nicollsf/monsoon/report/pictures/shared image (17).jpeg

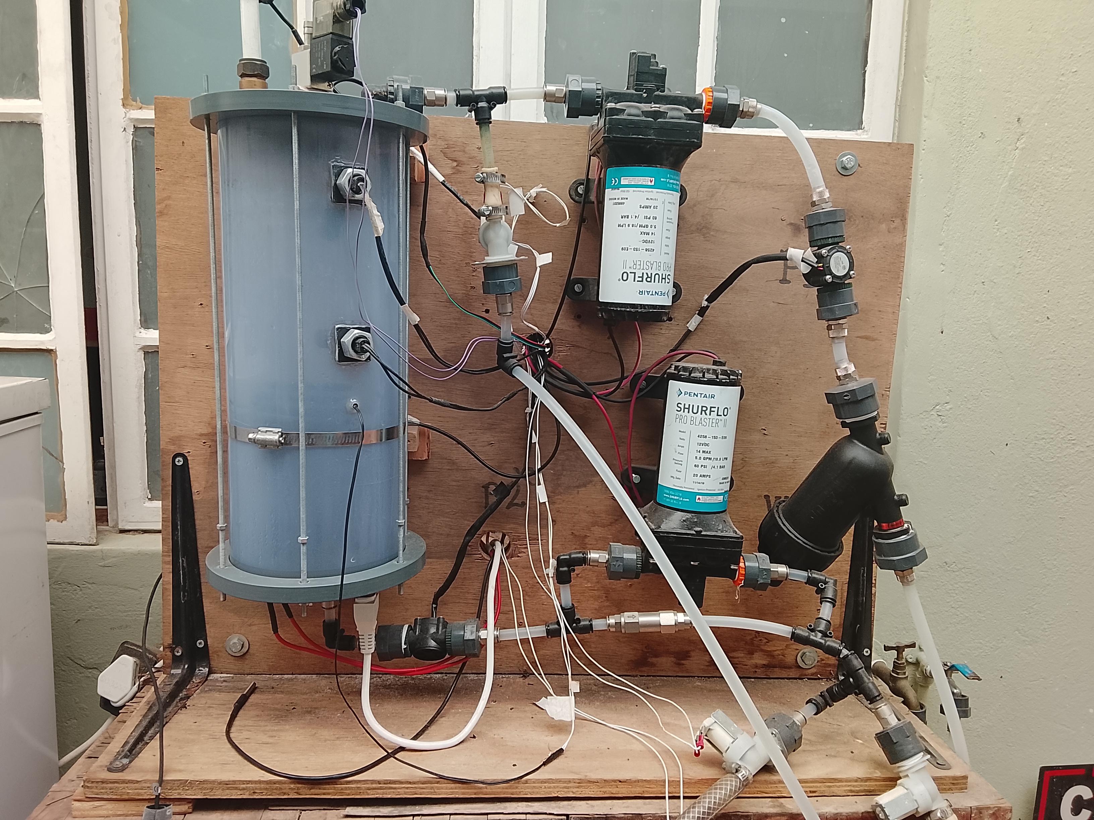
report/pictures/shared image (17).jpeg
