nicollsf/monsoon/report/monsoon.pptx

## Monsoon: The Journey

So many ways to go wrong

## Valves

## Slide 3

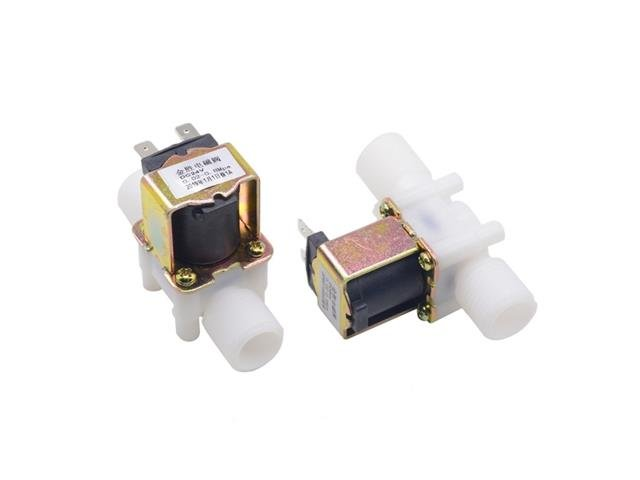
[picture p2: figure]

DC 12V

## Slide 4

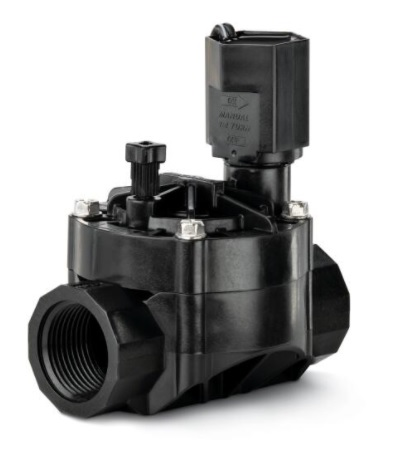
[picture p3: figure]

Irrigation

## Slide 5

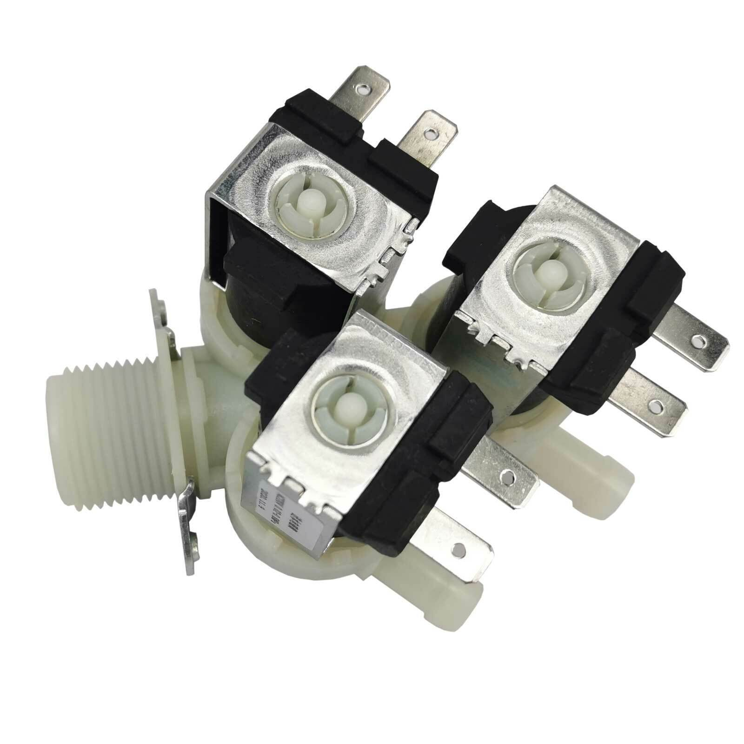
[picture p4: figure]

## Slide 6

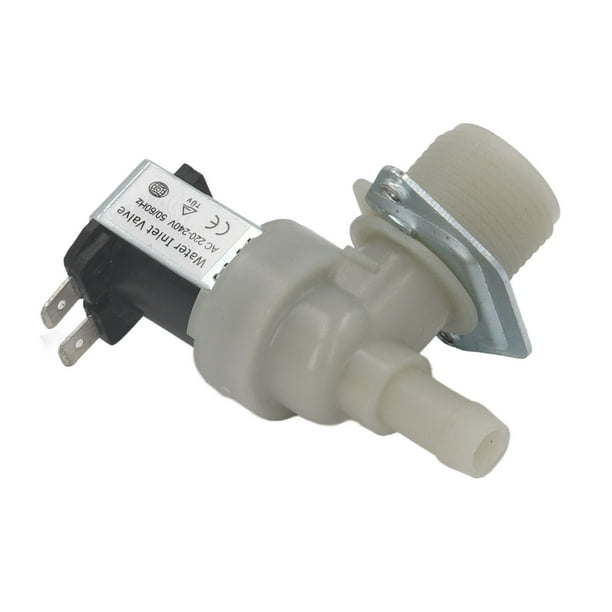
[picture p5: figure]

## Slide 7

- Don’t try to suck through a valve
- It’s a washing machine

## Pumps

## Slide 9

Agricultural

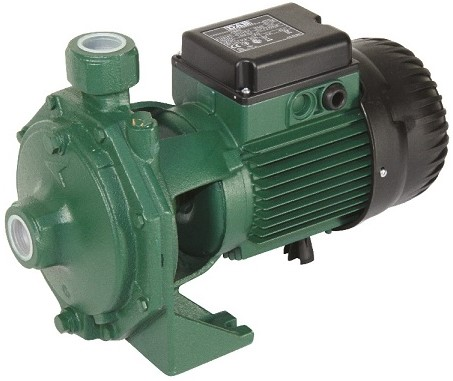
[picture p6: figure]

## Slide 10

Bilge

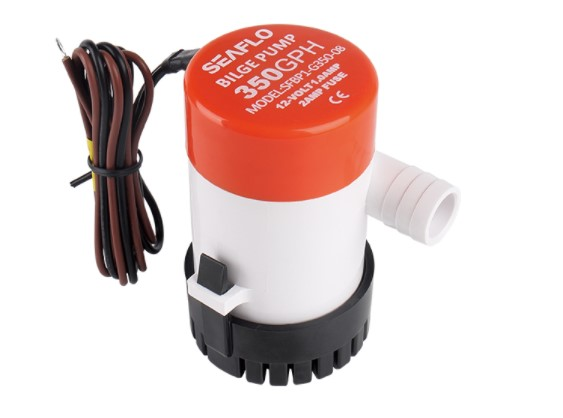
[picture p7: figure]

## Slide 11

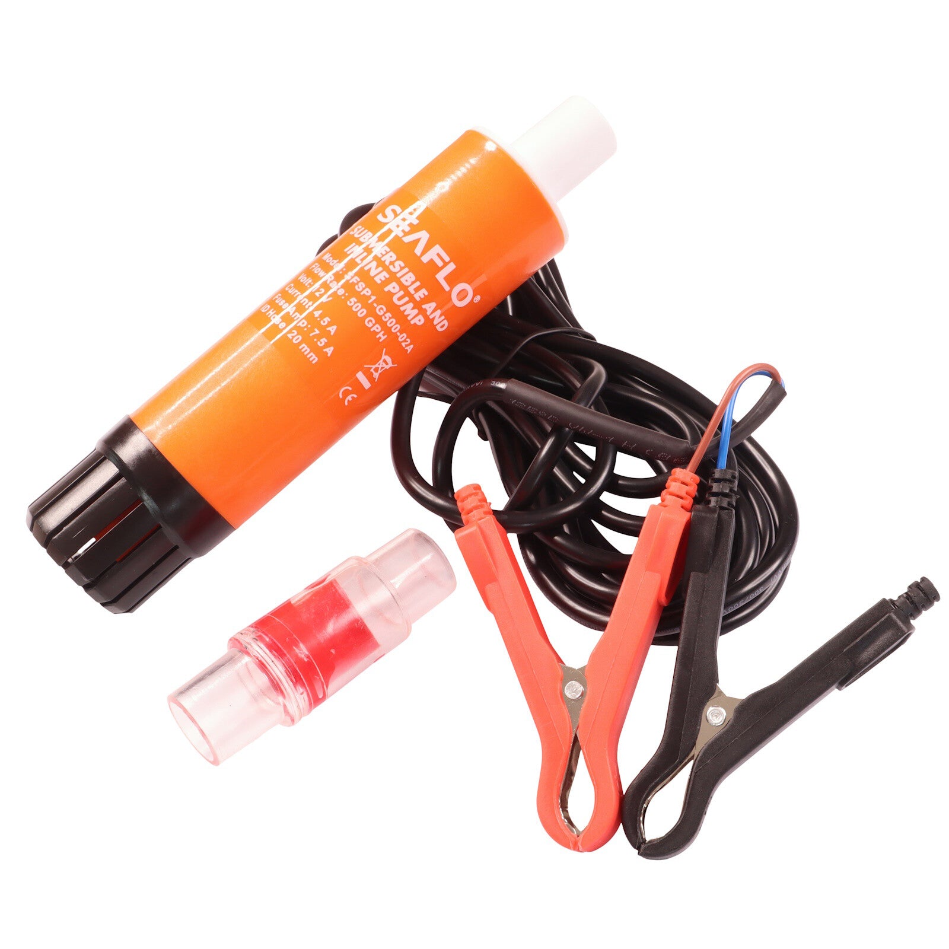
[picture p8: figure]

Centrifugal

## Slide 12

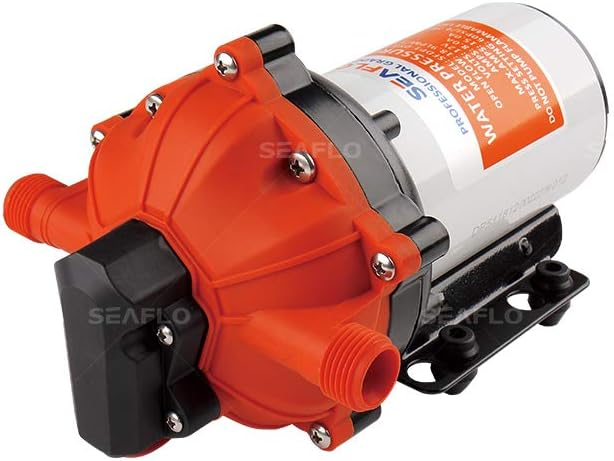
[picture p9: figure]

Washdown

## Prototype mark 2

## Slide 14

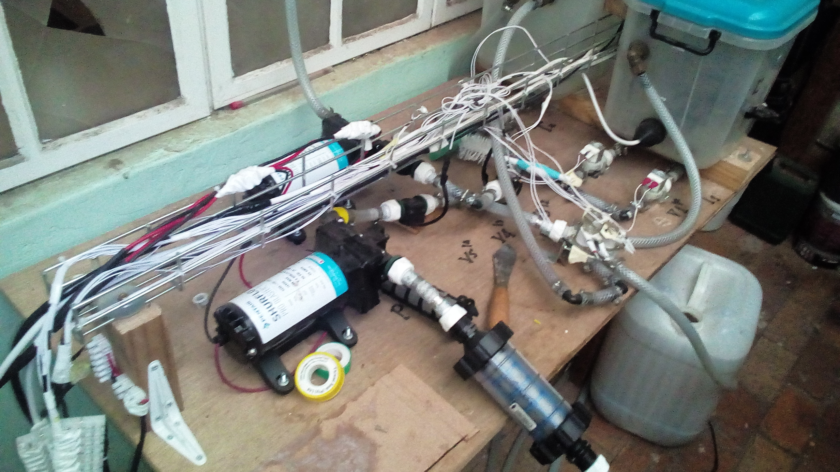
[picture p10: figure]

## Slide 15

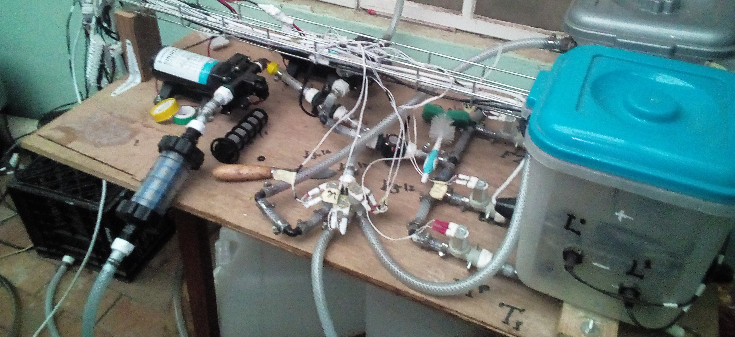
[picture p11: figure]

## Prototype Mark 3

## Slide 17

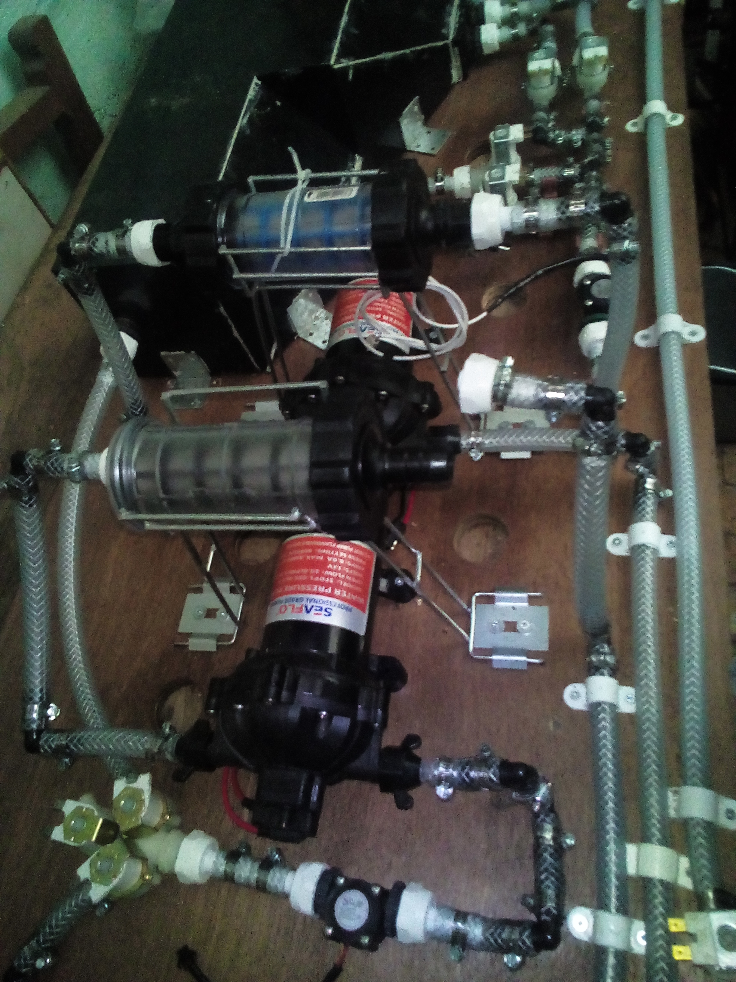
[picture p12: figure]
