nicollsf/monsoon/arduino/monsoon_mega3.1/heaterstep.pdf

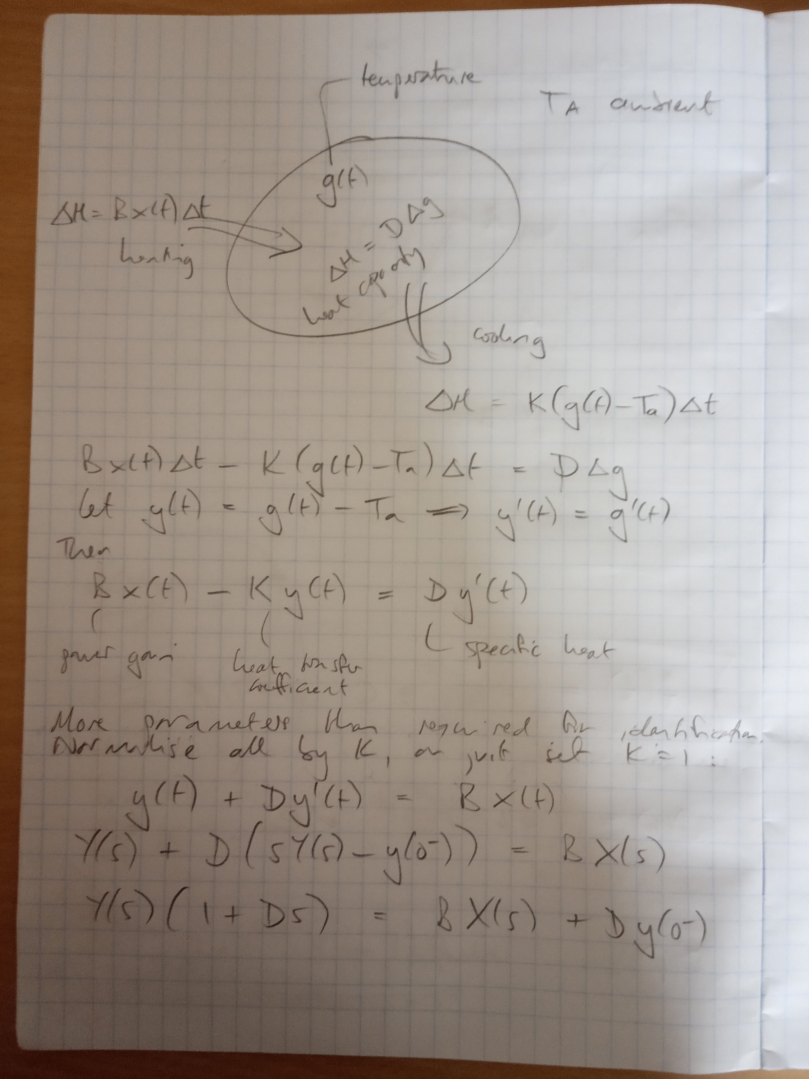
[picture p13: page 1]
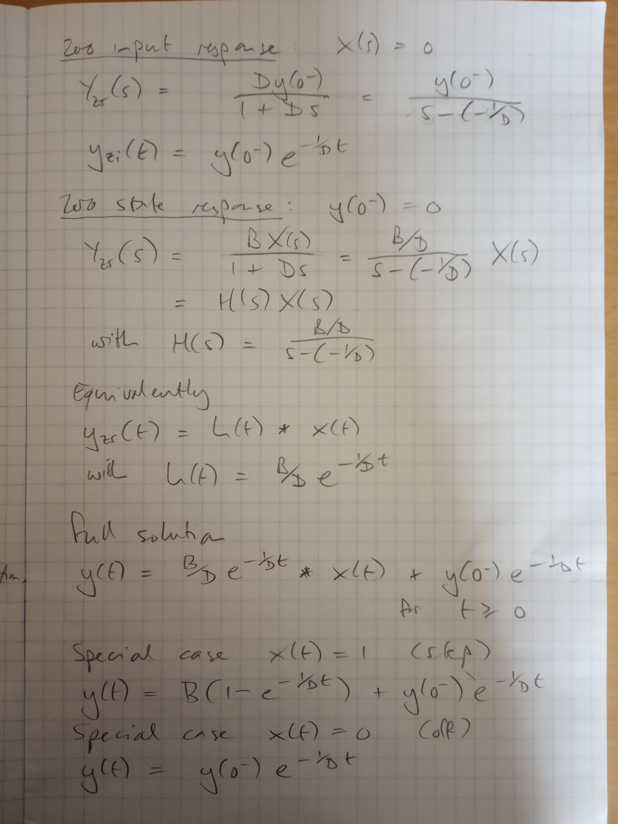
[picture p14: page 2]
