nicollsf/monsoon/arduino/monsoon_esp4.1/Wemos_D1_R32_pinout.png

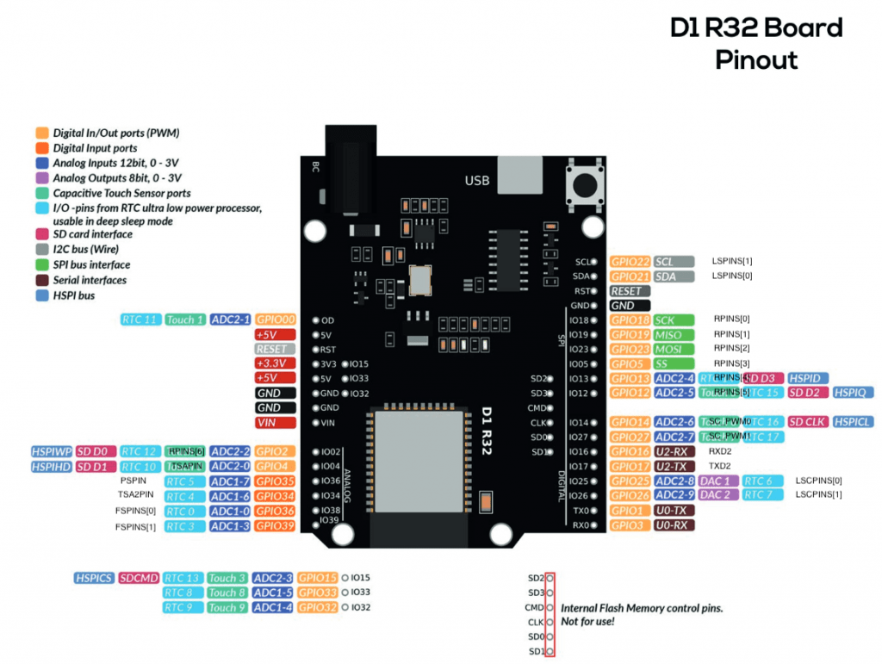
arduino/monsoon_esp4.1/Wemos_D1_R32_pinout.png
