nicollsf/monsoon/report/pictures/IMG_20180815_183408.jpg

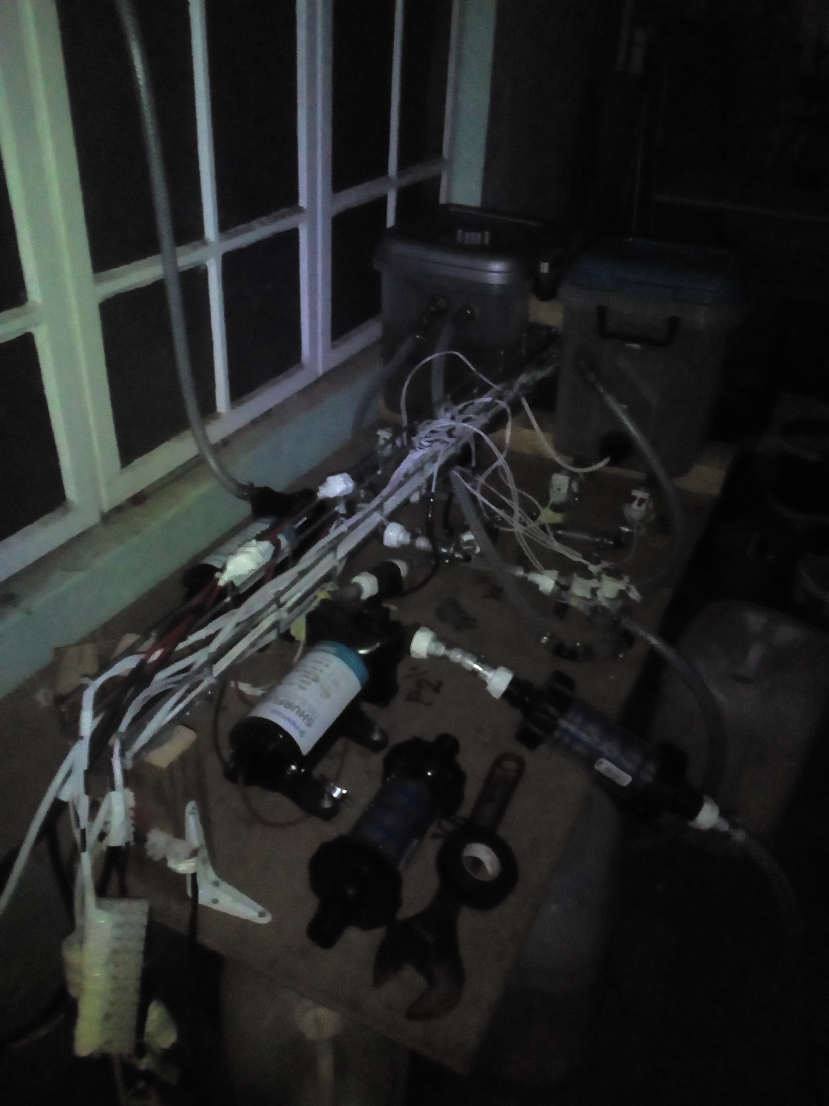
report/pictures/IMG_20180815_183408.jpg
