nicollsf/monsoon/report/pictures/IMG_20180815_183418.jpg

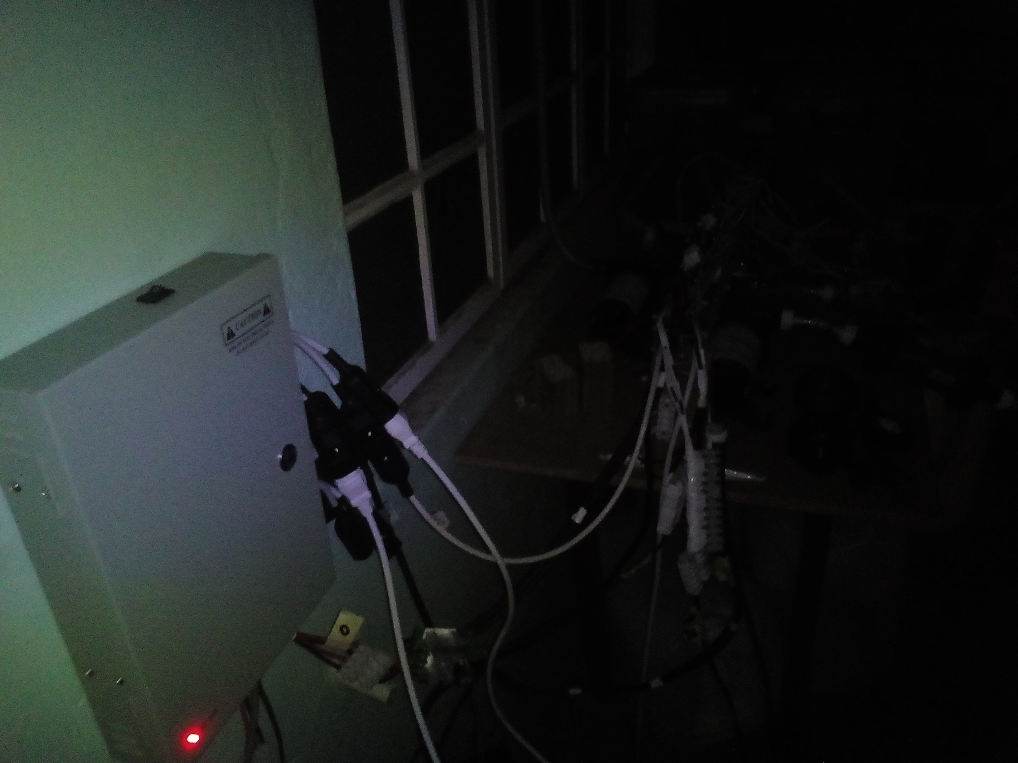
report/pictures/IMG_20180815_183418.jpg
