nicollsf/monsoon/report/pictures/IMG_20180919_072539.jpg

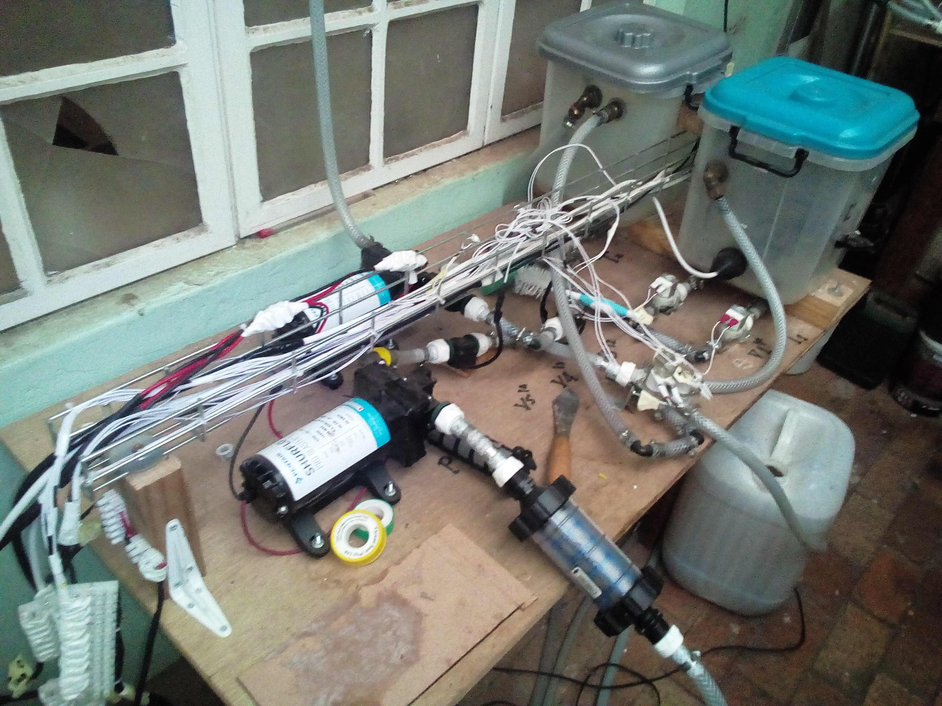
report/pictures/IMG_20180919_072539.jpg
