nicollsf/monsoon/report/pictures/IMG_20180919_072553.jpg

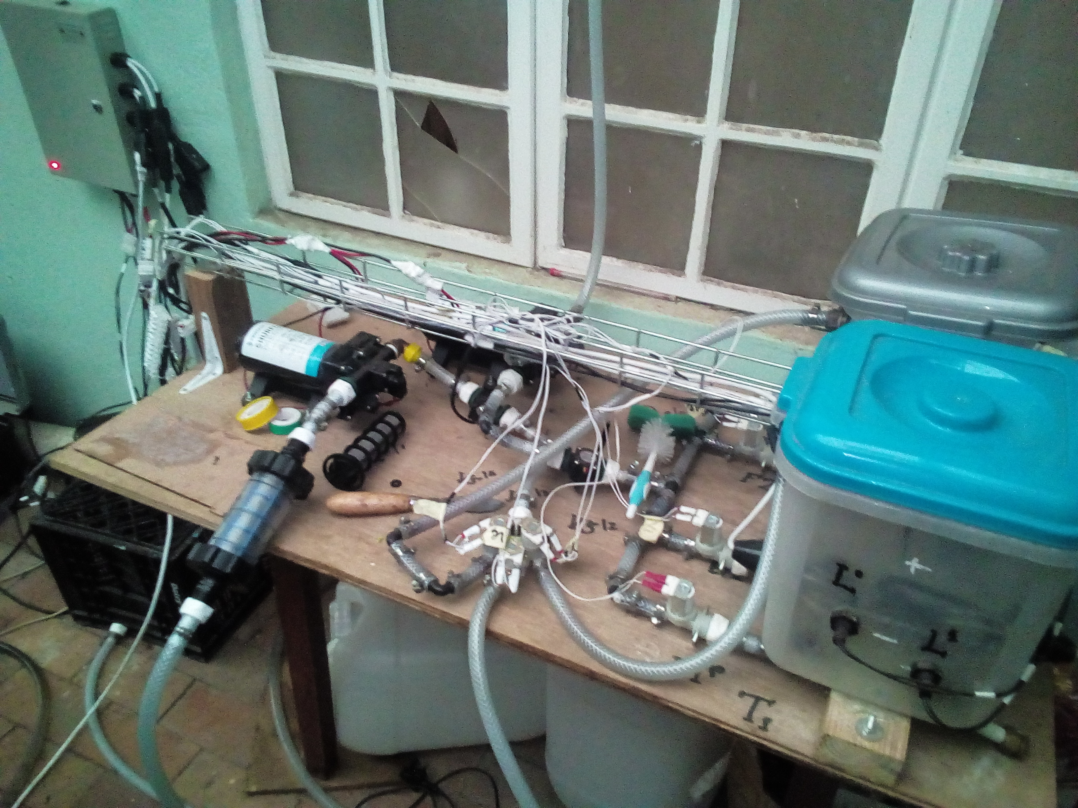
report/pictures/IMG_20180919_072553.jpg
