nicollsf/monsoon/report/pictures/shared image (13).jpeg

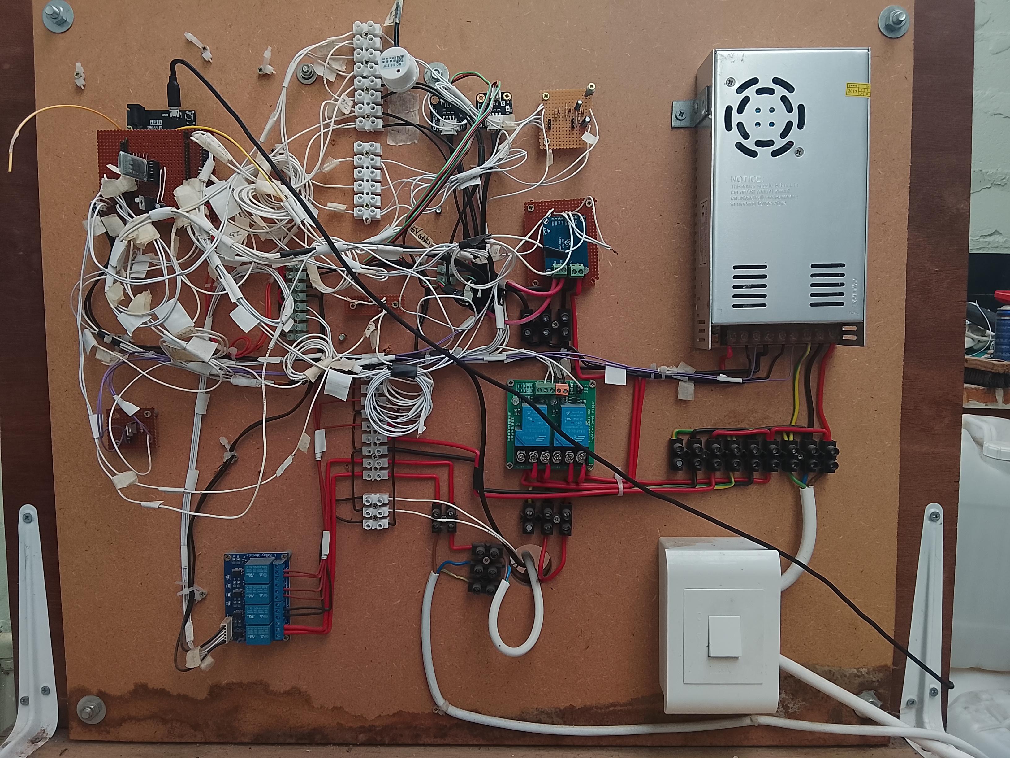
report/pictures/shared image (13).jpeg
