nicollsf/monsoon/report/pictures/shared image (14).jpeg

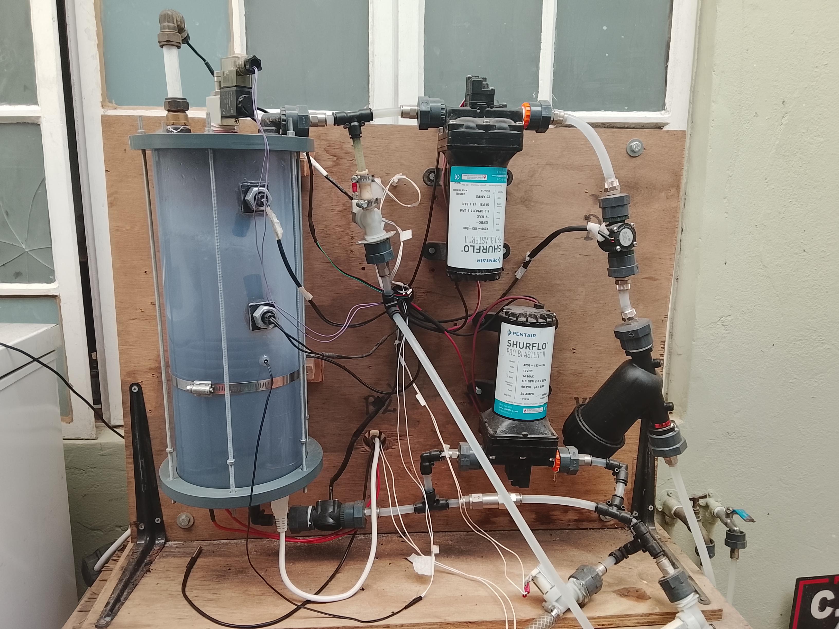
report/pictures/shared image (14).jpeg
