nicollsf/monsoon/tanks/Untitled.dxf

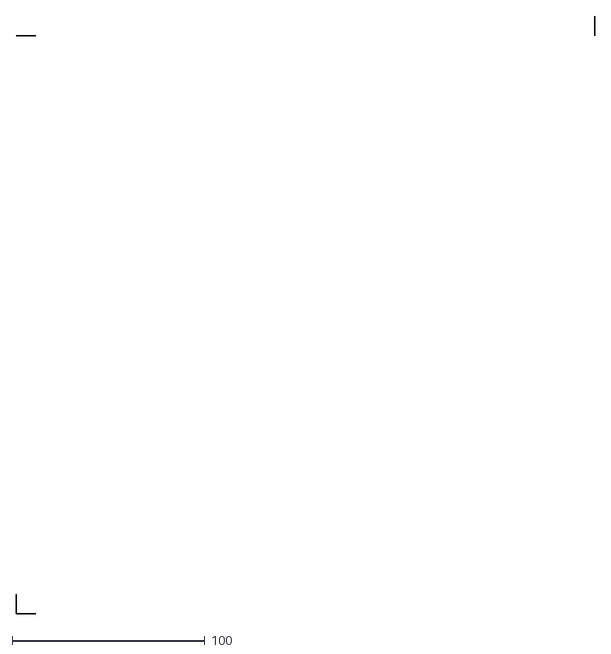
[picture p22: CAD file, 2026-03-22]
tanks/Untitled.dxf
300.0 x 310.0
