nicollsf/monsoon/tanks/tanks.dxf

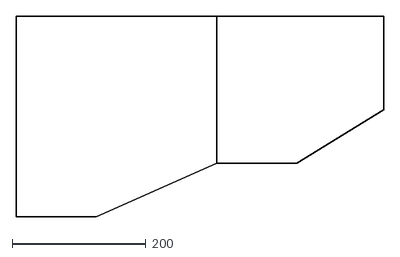
[picture p23: CAD file, 2026-03-22]
tanks/tanks.dxf
550.0 x 300.0
