nicollsf/monsoon/(list of files, drawings)

Other design files:
arduino/monsoon_esp4.1/heater_safety.fzz
arduino/monsoon_esp4.1/monsoon_esp.fzz
arduino/monsoon_esp4.2/monsoon_esp32devkit.fzz
arduino/monsoon_esp4/monsoon_esp.fzz
arduino/monsoon_mega2.1/monsoon_mega2.fzz
arduino/monsoon_mega2.2/monsoon_mega2.fzz
arduino/monsoon_mega2/monsoon_mega2.fzz
arduino/monsoon_mega3.1/monsoon_mega3.fzz
arduino/monsoon_mega3.2/monsoon_mega3.fzz
arduino/monsoon_mega3/monsoon_mega3.fzz
arduino/monsoon_mega/monsoon_mega.fzz
arduino/scavenge_level/scavenge_level.fzz
