nicollsf/monsoon/arduino/monsoon_esp4.2/calib.cpp

#include <Arduino.h>
#include <vector>
#include <Preferences.h>
#include "calib.h"
#include "auto.h"
#include "system.h"
#include "sensors.h"
#include "control.h"
#include "gui.h"

// ----------------------------------------------------------------------
//   Calibrations
// ----------------------------------------------------------------------

int calib_cind;
unsigned int calib_lastsettime;
unsigned int calib_laststagetime;


// Auto calibrate pumps

std::vector<float> calib_pumpperc = {10, 20, 30, 40, 50, 60, 70, 80, 90, 100};
std::vector<float> calib_dpumpmap, calib_rpumpmap;

const char *autocalibp_statestrs[] = {"NONE", "FILL", "PREPARE", "CALIB_DEL", "SCAV_PREP", "CALIB_SCAV", "DONE", "WTF"};
std::vector<float> pdpercv, trespv;
void loop_autocalibp(void)
{
  static int last_substate = -1;
  float flow_low, flow_high, current_target_lpm;

  if( auto_state!=STATE_CALIBP ) return;
  auto_substatestrs = autocalibp_statestrs;
  
  bool just_entered = (last_substate != auto_substate);
  last_substate = auto_substate;

  switch( auto_substate ) {
    case CALIBP_NONE:
      if( just_entered ) {
        auto_wtopupenable = 0;
        htrs_enable = 0;
        temp_controlmode = TCOFF;
        btLog("Entering CALIBP_NONE");
        calib_cind = -1;
        calib_dpumpmap.clear();
        calib_rpumpmap.clear();
      }
      Serial.println("Switching substate to CALIBP_FILL");
      auto_switchsubstate(CALIBP_FILL);
      break;

    case CALIBP_FILL:
      if( just_entered ) {
        btLog("CALIBP: Filling tank from mains inlet.");
        setrelay_en(RPINLET, RON);
      }

      if( tank_full ) {
        btLog("CALIBP: Tank is full. Moving to prepare/prime stage.");
        setrelay_en(RPINLET, ROFF);
        auto_switchsubstate(CALIBP_PREPARE);
      }
      break;

    case CALIBP_PREPARE:
      if( just_entered ) {
        btLog("CALIBP: Priming/stabilising circuit. SCAVENGE 100%, DELIVERY 50%, top-up ON.");
        setrelay_en(RPDELIVER, RON);
        setpump_en(RPUMPR, RON);
        setpump_en(RPUMPD, RON);
        setpump_perc(RPUMPR, 100);
        setpump_perc(RPUMPD, 50); // delivery ~50%
        auto_wtopupenable = 1;
      }

      // Wait for tank to be full and flow to be stable for 20s
      if( tank_full && (millis() - flow_lastlt1 > 20000) ) {
        btLog("CALIBP: Flow stable. Starting delivery pump calibration.");
        calib_cind = -1;
        auto_switchsubstate(CALIBP_CALIB_DELIVERY);
      }
      break;

    case CALIBP_CALIB_DELIVERY:
      if( just_entered ) {
        btLog("CALIBP: Starting delivery pump calibration step series.");
        calib_dpumpmap.clear();
        calib_cind = 0;
        setrelay_en(RPDELIVER, RON);
        setpump_en(RPUMPR, RON);
        setpump_perc(RPUMPR, 100); // Scavenge full to clear pan
        setpump_en(RPUMPD, RON);
        setpump_perc(RPUMPD, calib_pumpperc[calib_cind]);
        auto_wtopupenable = 1; // Keep tank full during delivery calibration
        calib_lastsettime = millis();
      }

      // Safeguard check
      if( tank_empty ) {
        btLog("ERROR: Tank level low during Delivery Calib. Aborting.");
        pumpsen_reset();
        auto_switchstate(STATE_OFF);
        return;
      }

      if( millis() - calib_lastsettime >= 5000 ) {
        float measured_flow = flow_lpm0;
        calib_dpumpmap.push_back(measured_flow);
        btLog("CALIBP: Delivery " + String(calib_pumpperc[calib_cind], 0) + "% -> Flow: " + String(measured_flow, 2) + " LPM");

        if( calib_cind < (int)calib_pumpperc.size() - 1 ) {
          calib_cind++;
          setpump_perc(RPUMPD, calib_pumpperc[calib_cind]);
          calib_lastsettime = millis();
        } else {
          // Delivery calibration complete
          std::vector<float> dpump_pwms;
          std::vector<float> dpump_flows;
          for (size_t i = 0; i < calib_pumpperc.size(); i++) {
            if (calib_pumpperc[i] <= 90.0f) {
              dpump_pwms.push_back(calib_pumpperc[i]);
              dpump_flows.push_back(calib_dpumpmap[i]);
            }
          }
          modeld = pumpcalib_fit(dpump_pwms, dpump_flows);
          pumpcalib_savemodels();
          btLog("CALIBP: Delivery pump calibration finished. Model fitted and saved.");
          auto_switchsubstate(CALIBP_SCAVENGE_PREP);
        }
      }
      break;

    case CALIBP_SCAVENGE_PREP:
      if( just_entered ) {
        btLog("CALIBP: Flooding pan. Scavenge off, top-up off, Delivery 90% until level low.");
        setpump_en(RPUMPR, ROFF);
        auto_wtopupenable = 0;
        setrelay_en(RPINLET, ROFF);
        setrelay_en(RPDELIVER, RON);
        setpump_perc(RPUMPD, 90);
        setpump_en(RPUMPD, RON);
      }

      // Wait until bottom level sensor hits low (which means pan is flooded/full)
      if( tank_empty ) {
        btLog("CALIBP: Tank level hit low (pan is full). Starting scavenge calibration steps.");
        calib_cind = -1;
        auto_switchsubstate(CALIBP_CALIB_SCAVENGE);
      }
      break;

    case CALIBP_CALIB_SCAVENGE:
      if( just_entered ) {
        btLog("CALIBP: Starting scavenge pump calibration step series with dynamic delivery.");
        calib_rpumpmap.clear();
        calib_cind = 0;
        setrelay_en(RPDELIVER, RON);
        setpump_perc(RPUMPR, calib_pumpperc[calib_cind]);
        setpump_en(RPUMPR, RON);
        calib_lastsettime = millis();
      }

      // Dynamic Delivery pump control:
      // drive the DELIVERY pump full (90%) when the tank level is high and have it off when the level is low.
      if( tank_full ) {
        setpump_perc(RPUMPD, 90);
        setpump_en(RPUMPD, RON);
      } else {
        setpump_en(RPUMPD, ROFF);
      }

      if( millis() - calib_lastsettime >= 5000 ) {
        float measured_flow = flow_lpm1;
        calib_rpumpmap.push_back(measured_flow);
        btLog("CALIBP: Scavenge " + String(calib_pumpperc[calib_cind], 0) + "% -> Flow: " + String(measured_flow, 2) + " LPM");

        if( calib_cind < (int)calib_pumpperc.size() - 1 ) {
          calib_cind++;
          setpump_perc(RPUMPR, calib_pumpperc[calib_cind]);
          calib_lastsettime = millis();
        } else {
          // Scavenge calibration finished
          modelr = pumpcalib_fit(calib_pumpperc, calib_rpumpmap);
          pumpcalib_savemodels();
          btLog("CALIBP: Scavenge pump calibration finished. Model fitted and saved.");
          auto_switchsubstate(CALIBP_DONE);
        }
      }
      break;

    case CALIBP_DONE:
      if( just_entered ) {
        auto_woverflowstopenable = 0;
        pumpsen_reset();
      }
      auto_switchstate(STATE_CALIBT);
      break;
  }
}


// Auto calibrate temperature (5 LPM step response & thermal lag characterization)
enum autocalibt_states {
  CALIBT_NONE = 0,
  CALIBT_BASELINE_IDLE,  // 1-2 min at 5 LPM with 0 kW heaters to reach flat baseline T0
  CALIBT_STEP_HEAT,      // Full 6 kW step test at 5 LPM until water reaches 50.0 C
  CALIBT_STABILIZE_HOLD, // Step down to ~4.8 kW (estimated 5 LPM hold) to observe steady-state
  CALIBT_COOL_DECAY,     // 0 kW heaters at 5 LPM to measure thermal decay / lag
  CALIBT_DONE
};

struct TempLogPoint {
  uint16_t time_sec;
  float temp_c;
  float flow0;
  float flow1;
  uint8_t target_lpm_x10;
  uint8_t power_kw_x10;
} __attribute__((packed));
std::vector<TempLogPoint> temp_response_log;

const char *autocalibt_statestrs[] = {"NONE", "BASELINE", "STEP_HEAT", "STABILIZE", "COOL_DECAY", "DONE", "WTF"};
void loop_autocalibt(void)
{
  static int last_substate = -1;
  static unsigned long last_sample_time = 0;
  static unsigned long substate_start_time = 0;
  static float baseline_temp = 0.0f;

  const float CALIB_FLOW_LPM = 5.0f;       // Fixed delivery flow rate for test
  const float TARGET_HEAT_TEMP = 50.0f;     // Target heating ceiling
  const float MAX_SAFETY_TEMP = 55.0f;      // Abort threshold

  if( auto_state!=STATE_CALIBT ) return;
  auto_substatestrs = autocalibt_statestrs;

  bool just_entered = (last_substate != auto_substate);
  last_substate = auto_substate;

  if (just_entered) {
    substate_start_time = millis();
  }

  // Periodic 1-second data logging into temp_response_log
  if (millis() - last_sample_time >= 1000) {
    last_sample_time = millis();
    bool aux_on = (getrelay_en(RPHEATERA) == RON);
    float current_kw = (4.0f * ssr_main_duty) + (aux_on ? 2.0f : 0.0f);

    TempLogPoint p;
    p.time_sec = (uint16_t)((millis() - auto_statestime) / 1000);
    p.temp_c = temp1;
    p.flow0 = flow_lpm0;
    p.flow1 = flow_lpm1_est;
    p.target_lpm_x10 = (uint8_t)(CALIB_FLOW_LPM * 10);
    p.power_kw_x10 = (uint8_t)(current_kw * 10.0f + 0.5f);
    temp_response_log.push_back(p);
  }
  
  switch( auto_substate ) {
    case CALIBT_NONE:
      if( just_entered ) {
        btLog("CALIBT: Initializing 5.0 LPM Thermal Lag & Step Test.");
        auto_wtopupenable = 0;
        auto_woverflowstopenable = 1;
        auto_scavengecontrolenable = 1; // Closed-loop recovery matching WASH
        temp_controlmode = TCNONE;      // Direct manual control of heaters in this state
        htrs_enable = 1;
        ssr_main_duty = 0.0f;
        setrelay_en(RPHEATER, ROFF);
        setrelay_en(RPHEATERA, ROFF);

        temp_response_log.clear();
        temp_response_log.reserve(1200);

        Preferences p;
        p.begin("calibt", false);
        p.clear();
        p.end();
      }
      auto_switchsubstate(CALIBT_BASELINE_IDLE);
      break;

    case CALIBT_BASELINE_IDLE: {
      // Phase 1: Unheated baseline at 5.0 LPM with closed-loop scavenge
      if( just_entered ) {
        btLog("CALIBT Phase 1: Baseline idle (0 kW @ 5.0 LPM) for 90s to reach thermal equilibrium.");
        setrelay_en(RPDELIVER, RON);
        setpump_en(RPUMPD, RON);
        setpump_en(RPUMPR, RON);
        auto_scavengecontrolenable = 1;
        setpump_lpm(RPUMPD, CALIB_FLOW_LPM);

        ssr_main_duty = 0.0f;
        setrelay_en(RPHEATER, ROFF);
        setrelay_en(RPHEATERA, ROFF);
      }

      unsigned long elapsed = millis() - substate_start_time;
      // Wait 90 seconds (1.5 min) to reach flat initial baseline
      if (elapsed >= 90000) {
        baseline_temp = temp1;
        btLog("CALIBT: Baseline established at " + String(baseline_temp, 2) + " C. Commencing 6.0 kW Step!");
        auto_switchsubstate(CALIBT_STEP_HEAT);
      }
      break;
    }

    case CALIBT_STEP_HEAT: {
      // Phase 2: Instantaneous 6 kW step test at 5.0 LPM until 50.0 C
      if( just_entered ) {
        btLog("CALIBT Phase 2: 6.0 kW STEP (Main 100% + Aux ON) @ 5.0 LPM. Heating towards " + String(TARGET_HEAT_TEMP, 1) + " C.");
        setrelay_en(RPDELIVER, RON);
        setpump_en(RPUMPD, RON);
        setpump_en(RPUMPR, RON);
        auto_scavengecontrolenable = 1;
        setpump_lpm(RPUMPD, CALIB_FLOW_LPM);

        ssr_main_duty = 1.0f;
        setrelay_en(RPHEATER, RON);
        setrelay_en(RPHEATERA, RON); // Full 6 kW
      }

      // Check if target temperature reached or safety limit
      if (temp1 >= TARGET_HEAT_TEMP) {
        btLog("CALIBT: Target 50 C reached (T=" + String(temp1, 2) + " C). Transitioning to stabilization hold.");
        auto_switchsubstate(CALIBT_STABILIZE_HOLD);
      } else if (temp1 >= MAX_SAFETY_TEMP) {
        btLog("WARNING: Max safety temp reached. Aborting to decay.");
        auto_switchsubstate(CALIBT_COOL_DECAY);
      }
      break;
    }

    case CALIBT_STABILIZE_HOLD: {
      // Phase 3: Hold power to stabilize around 50 C
      // At 5 LPM and dT ~ (50 - 25) = 25 C: equilibrium power is ~4.8 kW (Aux 2kW + Main 70% = 4.8 kW)
      if( just_entered ) {
        btLog("CALIBT Phase 3: Stabilizing at ~4.8 kW (Aux ON + Main 70%) @ 5.0 LPM.");
        setrelay_en(RPDELIVER, RON);
        setpump_en(RPUMPD, RON);
        setpump_en(RPUMPR, RON);
        auto_scavengecontrolenable = 1;
        setpump_lpm(RPUMPD, CALIB_FLOW_LPM);

        setrelay_en(RPHEATERA, RON); // 2 kW
        ssr_main_duty = 0.70f;        // 2.8 kW (4.8 kW total)
        setrelay_en(RPHEATER, RON);
      }

      unsigned long hold_elapsed = millis() - substate_start_time;

      // Check for stability: after at least 60s, check if temp drift over last 30s is < 0.15 C
      if (hold_elapsed >= 60000 && temp_response_log.size() >= 30) {
        float temp_30s_ago = temp_response_log[temp_response_log.size() - 30].temp_c;
        if (abs(temp1 - temp_30s_ago) <= 0.15f || hold_elapsed >= 180000) { // 3 min max hold
          btLog("CALIBT: Temperature stabilized at " + String(temp1, 2) + " C (Hold power 4.8 kW). Commencing unheated decay.");
          auto_switchsubstate(CALIBT_COOL_DECAY);
        }
      }
      break;
    }

    case CALIBT_COOL_DECAY: {
      // Phase 4: Zero-power thermal decay at 5.0 LPM
      // Target: Decay until 5 degrees above ambient (or 10 minutes max, whichever first)
      float amb_ref = (baseline_temp > 10.0f) ? baseline_temp : ambient_water_cold;
      float decay_target_temp = amb_ref + 5.0f;
      const unsigned long MAX_DECAY_DURATION = 600000; // 10 minutes (600,000 ms)

      if( just_entered ) {
        btLog("CALIBT Phase 4: Heaters 0% (0 kW). Logging temperature decay at 5.0 LPM towards " + 
              String(decay_target_temp, 1) + " C (Amb+5C or 10 min max).");
        setrelay_en(RPDELIVER, RON);
        setpump_en(RPUMPD, RON);
        setpump_en(RPUMPR, RON);
        auto_scavengecontrolenable = 1;
        setpump_lpm(RPUMPD, CALIB_FLOW_LPM);

        ssr_main_duty = 0.0f;
        setrelay_en(RPHEATER, ROFF);
        setrelay_en(RPHEATERA, ROFF);
      }

      unsigned long decay_elapsed = millis() - substate_start_time;
      bool target_reached = (temp1 <= decay_target_temp);
      bool timeout = (decay_elapsed >= MAX_DECAY_DURATION);

      // Log cooling decay until within 5C of ambient or 10 minutes
      if (target_reached || timeout) {
        if (target_reached) {
          btLog("CALIBT Phase 4 complete: Temperature reached " + String(temp1, 2) + " C (Amb+5C reached in " + 
                String(decay_elapsed / 1000) + "s).");
        } else {
          btLog("CALIBT Phase 4 complete: 10-minute timeout reached. Final temp: " + String(temp1, 2) + " C.");
        }
        calib_archive_log();
        auto_switchsubstate(CALIBT_DONE);
      }
      break;
    }

    case CALIBT_DONE:
      if( just_entered ) {
        btLog("CALIBT: Test complete. Switching to CALIBDUMP.");
        auto_woverflowstopenable = 0;
        auto_scavengecontrolenable = 0;
        temp_controlmode = TCNONE;
        ssr_main_duty = 0.0f;
        setrelay_en(RPHEATER, ROFF);
        setrelay_en(RPHEATERA, ROFF);
        pumpsen_reset();
      }
      auto_switchstate(STATE_CALIBDUMP);
      break;
  }
}


// Auto calibrate dump
enum autocalibdump_states {
  CALIBDUMP_NONE = 0,
  CALIBDUMP_DUMP,
  CALIBDUMP_DONE
};
const char *autocalibdump_statestrs[] = {"NONE", "DUMP", "DONE", "WTF"};
void loop_autocalibdump(void)
{
  static int last_substate = -1;
  if( auto_state!=STATE_CALIBDUMP ) return;
  auto_substatestrs = autocalibdump_statestrs;
  
  bool just_entered = (last_substate != auto_substate);
  last_substate = auto_substate;

  switch( auto_substate ) {
    case CALIBDUMP_NONE:
      if( just_entered ) btLog("Entering CALIBDUMP_NONE");
      auto_switchsubstate(CALIBDUMP_DUMP);
      break;

    case CALIBDUMP_DUMP:
      if( just_entered ) {
        btLog("Dumping Calibration Info from NVRAM");
        
        Serial.println("\n--- START STORED PUMP MODELS ---");
        Serial.printf("Model R: offset=%.2f, a=%.4f, b=%.4f, maxflow=%.2f\n", modelr.offset, modelr.a, modelr.b, modelr.maxflow);
        Serial.printf("Model D: offset=%.2f, a=%.4f, b=%.4f, maxflow=%.2f\n", modeld.offset, modeld.a, modeld.b, modeld.maxflow);
        Serial.println("--- END STORED PUMP MODELS ---\n");

        extern void mqtt_log(String slog);
        mqtt_log("CALIB_PUMP_MODEL_R: offset=" + String(modelr.offset) + ", a=" + String(modelr.a, 4) + ", b=" + String(modelr.b, 4) + ", maxflow=" + String(modelr.maxflow));
        mqtt_log("CALIB_PUMP_MODEL_D: offset=" + String(modeld.offset) + ", a=" + String(modeld.a, 4) + ", b=" + String(modeld.b, 4) + ", maxflow=" + String(modeld.maxflow));

        {
          Preferences p;
          p.begin("calibt", false);
          size_t len = 0;
          if (p.isKey("log")) {
             len = p.getBytesLength("log");
          }
          if (len > 0 && (len % sizeof(TempLogPoint) == 0)) {
             uint8_t* buf = new uint8_t[len];
             p.getBytes("log", buf, len);
             int count = len / sizeof(TempLogPoint);
             TempLogPoint* pts = (TempLogPoint*)buf;
             Serial.println("Time_sec, Target_LPM, Power_kW, Temp_C, Flow_LPM0, Flow_LPM1");
             
             mqtt_log("CALIB_TEMP_LOG_START");
             for(int i=0; i<count; i++) {
               float p_kw = pts[i].power_kw_x10 / 10.0f;
               Serial.printf("%d, %.1f, %.1f, %.2f, %.2f, %.2f\n", pts[i].time_sec, pts[i].target_lpm_x10/10.0f, p_kw, pts[i].temp_c, pts[i].flow0, pts[i].flow1);
               String pts_str = "CALIB_PT: t=" + String(pts[i].time_sec) + 
                                ", target=" + String(pts[i].target_lpm_x10/10.0f, 1) + 
                                ", kw=" + String(p_kw, 1) + 
                                ", temp=" + String(pts[i].temp_c, 2) + 
                                ", flow0=" + String(pts[i].flow0, 2) + 
                                ", flow1=" + String(pts[i].flow1, 2);
               mqtt_log(pts_str);
             }
             mqtt_log("CALIB_TEMP_LOG_END");
             
             delete[] buf;
          } else {
             Serial.println("No NVRAM temp log found.");
             mqtt_log("CALIB_TEMP_LOG_EMPTY");
          }
          p.end();
        }

        Serial.println("========================================\n");
      }

      auto_switchsubstate(CALIBDUMP_DONE);
      break;

    case CALIBDUMP_DONE:
      if( just_entered ) auto_switchstate(STATE_OFF);
      break;
  }
}

// Auto calibrate relative flow between turbine meters (Switch-to-Switch Volumetric Ratio)
const char *autocalibf_statestrs[] = {"NONE", "INIT_FILL", "DRAIN_DEL", "FILL_REC", "CALC", "DONE", "WTF"};

static int calibf_cycle = 0;
const int CALIBF_MAX_CYCLES = 6;
const float calibf_pwms[CALIBF_MAX_CYCLES] = {30.0f, 40.0f, 52.0f, 65.0f, 80.0f, 95.0f};

static unsigned long calibf_del_pulses[CALIBF_MAX_CYCLES];
static unsigned long calibf_rec_pulses[CALIBF_MAX_CYCLES];
static unsigned long calibf_del_dur_ms[CALIBF_MAX_CYCLES];
static unsigned long calibf_rec_dur_ms[CALIBF_MAX_CYCLES];

void loop_autocalibf(void)
{
  static int last_substate = -1;
  extern void mqtt_log(String slog);

  if( auto_state != STATE_CALIBF ) return;
  auto_substatestrs = autocalibf_statestrs;

  bool just_entered = (last_substate != auto_substate);
  last_substate = auto_substate;

  switch( auto_substate ) {
    case CALIBF_NONE:
      if( just_entered ) {
        auto_wtopupenable = 0;
        auto_woverflowstopenable = 0;
        auto_scavengecontrolenable = 0;
        htrs_enable = 0;
        temp_controlmode = TCOFF;
        calibf_cycle = -1; // Start with unrecorded warmup/purge cycle
        for (int i = 0; i < CALIBF_MAX_CYCLES; i++) {
          calibf_del_pulses[i] = 0;
          calibf_rec_pulses[i] = 0;
          calibf_del_dur_ms[i] = 0;
          calibf_rec_dur_ms[i] = 0;
        }
        btLog("CALIBF: Starting Multi-Point Flow Calibration (Warmup + 6 speeds).");
        mqtt_log("CALIBF: Starting Multi-Point Flow Calibration (Warmup + 6 speeds: 30%, 40%, 52%, 65%, 80%, 95% PWM).");
      }
      if (tank_full) {
        auto_switchsubstate(CALIBF_DRAIN_DELIVERY);
      } else {
        auto_switchsubstate(CALIBF_INIT_FILL);
      }
      break;

    case CALIBF_INIT_FILL:
      if( just_entered ) {
        btLog("CALIBF: Charging tank with mains inlet to Top Float switch...");
        mqtt_log("CALIBF: Charging tank to Top Float...");
        setrelay_en(RPINLET, RON);
      }
      if (tank_full) {
        setrelay_en(RPINLET, ROFF);
        btLog("CALIBF: Tank full reached. Starting Warmup Drain Phase.");
        auto_switchsubstate(CALIBF_DRAIN_DELIVERY);
      }
      break;

    case CALIBF_DRAIN_DELIVERY: {
      float current_pwm = (calibf_cycle < 0) ? 50.0f : calibf_pwms[calibf_cycle];
      if( just_entered ) {
        flow_reset_total_pulses();
        calib_lastsettime = millis();
        setrelay_en(RPINLET, ROFF);
        setrelay_en(RPDRAIN, ROFF);
        setrelay_en(RPDELIVER, RON);
        setrelay_en(RPPUMP, RON);
        setpump_en(RPUMPR, ROFF);
        setpump_perc(RPUMPR, 0);
        setpump_perc(RPUMPD, current_pwm);
        setpump_en(RPUMPD, RON);

        String msg;
        if (calibf_cycle < 0) {
          msg = "CALIBF [WARMUP] DRAIN: Running Delivery at 50% PWM to purge air & prime lines...";
        } else {
          msg = "CALIBF [Cycle " + String(calibf_cycle + 1) + "/" + String(CALIBF_MAX_CYCLES) + 
                "] DRAIN: Running Delivery at " + String(current_pwm, 0) + "% PWM until Bottom Float...";
        }
        btLog(msg);
        mqtt_log(msg);
      }

      // Keep intent energized
      setrelay_en(RPDELIVER, RON);
      setrelay_en(RPPUMP, RON);
      setpump_perc(RPUMPD, current_pwm);
      setpump_en(RPUMPD, RON);

      // Must run for at least 5s to leave top float before evaluating bottom float
      if (millis() - auto_substatestime > 5000 && tank_empty) {
        unsigned long dur = millis() - calib_lastsettime;
        unsigned long pulses = total_flow_pulses0;
        if (calibf_cycle >= 0) {
          calibf_del_pulses[calibf_cycle] = pulses;
          calibf_del_dur_ms[calibf_cycle] = dur;
        }

        setpump_en(RPUMPD, ROFF);
        setpump_perc(RPUMPD, 0);

        float del_lpm = (10.0f / 82.0f) * ((float)pulses / (dur / 1000.0f));
        String doneMsg;
        if (calibf_cycle < 0) {
          doneMsg = "CALIBF [WARMUP] Delivery Drained: " + String(pulses) + " pulses in " + 
                    String(dur / 1000.0f, 1) + "s. Switching to Warmup Recovery...";
        } else {
          doneMsg = "CALIBF Cycle " + String(calibf_cycle + 1) + " Delivery Drained: " + 
                    String(pulses) + " pulses in " + String(dur / 1000.0f, 1) + "s (avg " + 
                    String(del_lpm, 2) + " LPM).";
        }
        btLog(doneMsg);
        mqtt_log(doneMsg);

        auto_switchsubstate(CALIBF_FILL_RECOVERY);
      }
      break;
    }

    case CALIBF_FILL_RECOVERY: {
      float current_pwm = (calibf_cycle < 0) ? 50.0f : calibf_pwms[calibf_cycle];
      if( just_entered ) {
        flow_reset_total_pulses();
        calib_lastsettime = millis();
        setrelay_en(RPDELIVER, RON); // keep deliver circuit open if required
        setrelay_en(RPPUMP, RON);
        setpump_en(RPUMPD, ROFF);
        setpump_perc(RPUMPD, 0);
        setpump_perc(RPUMPR, current_pwm);
        setpump_en(RPUMPR, RON);

        String msg;
        if (calibf_cycle < 0) {
          msg = "CALIBF [WARMUP] FILL: Running Recovery at 50% PWM to fully de-aerate & wet turbine...";
        } else {
          msg = "CALIBF [Cycle " + String(calibf_cycle + 1) + "/" + String(CALIBF_MAX_CYCLES) + 
                "] FILL: Running Recovery at " + String(current_pwm, 0) + "% PWM until Top Float...";
        }
        btLog(msg);
        mqtt_log(msg);
      }

      // Keep intent energized
      setrelay_en(RPDELIVER, RON);
      setrelay_en(RPPUMP, RON);
      setpump_perc(RPUMPR, current_pwm);
      setpump_en(RPUMPR, RON);

      // Must run for at least 5s to clear bottom float before checking top float
      if (millis() - auto_substatestime > 5000 && tank_full) {
        unsigned long dur = millis() - calib_lastsettime;
        unsigned long pulses = total_flow_pulses1;
        if (calibf_cycle >= 0) {
          calibf_rec_pulses[calibf_cycle] = pulses;
          calibf_rec_dur_ms[calibf_cycle] = dur;
        }

        setpump_en(RPUMPR, ROFF);
        setpump_perc(RPUMPR, 0);

        if (calibf_cycle < 0) {
          String doneMsg = "CALIBF: Warmup cycle complete (lines de-aerated and primed). Starting official 6-point calibration...";
          btLog(doneMsg);
          mqtt_log(doneMsg);
          calibf_cycle = 0;
          auto_switchsubstate(CALIBF_DRAIN_DELIVERY);
        } else {
          float raw_rec_lpm = (10.0f / 82.0f) * ((float)pulses / (dur / 1000.0f));
          float k_ratio = (calibf_del_pulses[calibf_cycle] > 0 && pulses > 0) ? 
                          ((float)calibf_del_pulses[calibf_cycle] / (float)pulses) : 1.0f;
          float corr_rec_lpm = raw_rec_lpm * k_ratio;

          String doneMsg = "CALIBF Cycle " + String(calibf_cycle + 1) + " Recovery Filled: " + 
                           String(pulses) + " pulses in " + String(dur / 1000.0f, 1) + "s (raw " + 
                           String(raw_rec_lpm, 2) + " LPM, corrected " + String(corr_rec_lpm, 2) + 
                           " LPM, K=" + String(k_ratio, 4) + ").";
          btLog(doneMsg);
          mqtt_log(doneMsg);

          calibf_cycle++;
          if (calibf_cycle < CALIBF_MAX_CYCLES) {
            auto_switchsubstate(CALIBF_DRAIN_DELIVERY);
          } else {
            auto_switchsubstate(CALIBF_CALCULATE);
          }
        }
      }
      break;
    }

    case CALIBF_CALCULATE:
      if( just_entered ) {
        pumpsen_reset();
        float raw_pts[CALIBF_MAX_CYCLES];
        float corr_pts[CALIBF_MAX_CYCLES];

        mqtt_log("================================================================");
        mqtt_log("CALIBF MULTI-POINT FLOW CALIBRATION TABLE");
        mqtt_log("Cycle | PWM% | Del LPM | Raw Rec LPM | Corr Rec LPM | K (Del/Rec)");

        for (int i = 0; i < CALIBF_MAX_CYCLES; i++) {
          float del_lpm = (calibf_del_dur_ms[i] > 0) ? 
                          ((10.0f / 82.0f) * ((float)calibf_del_pulses[i] / (calibf_del_dur_ms[i] / 1000.0f))) : 0.0f;
          float raw_rec_lpm = (calibf_rec_dur_ms[i] > 0) ? 
                              ((10.0f / 82.0f) * ((float)calibf_rec_pulses[i] / (calibf_rec_dur_ms[i] / 1000.0f))) : 0.0f;
          float k_ratio = (calibf_rec_pulses[i] > 0) ? 
                          ((float)calibf_del_pulses[i] / (float)calibf_rec_pulses[i]) : 1.0f;
          float corr_rec_lpm = raw_rec_lpm * k_ratio;

          raw_pts[i] = raw_rec_lpm;
          corr_pts[i] = corr_rec_lpm;

          String row = "  #" + String(i + 1) + "   | " + String(calibf_pwms[i], 0) + "%  |  " + 
                       String(del_lpm, 2) + "   |    " + String(raw_rec_lpm, 2) + "    |    " + 
                       String(corr_rec_lpm, 2) + "     |  " + String(k_ratio, 4);
          mqtt_log(row);
          Serial.println(row);
        }

        // Save full piecewise-linear calibration curve and direct PWM lookup to NVRAM
        save_calibf_table(CALIBF_MAX_CYCLES, raw_pts, corr_pts, calibf_pwms);

        String summary = "CALIBF FINAL: Saved " + String(CALIBF_MAX_CYCLES) + 
                         "-point piecewise linear curve to NVRAM. Recovery flow is now corrected to Delivery units across all flow rates!";
        btLog(summary);
        mqtt_log(summary);
        mqtt_log("================================================================");

        auto_switchsubstate(CALIBF_DONE);
      }
      break;

    case CALIBF_DONE:
      if( just_entered ) {
        pumpsen_reset();
        btLog("CALIBF: Relative flow calibration complete.");
      }
      auto_switchstate(STATE_OFF, "CALIBF Complete");
      break;
  }
}

void loop_calib(void)
{
  loop_autocalibp();
  loop_autocalibt();
  loop_autocalibdump();
  loop_autocalibf();
}

void calib_archive_log(void) {
    if (temp_response_log.empty()) {
        return; // Nothing to save
    }

    Preferences prefs;
    prefs.begin("calibt", false);
    if (prefs.putBytes("log", temp_response_log.data(), temp_response_log.size() * sizeof(TempLogPoint))) {
        btLog("CALIBT log (" + String(temp_response_log.size()) + " pts) archived to NVRAM.");
    } else {
        btLog("ERROR: Failed to archive CALIBT log to NVRAM.");
    }
    prefs.end();

    temp_response_log.clear(); // Free up memory
}
