nicollsf/monsoon/arduino/monsoon_esp4.2/gui.cpp

#include "gui.h"
#include "system.h"
#include "sensors.h"
#include "control.h"
#include "auto.h"
#include "ota.h"
#include "mqtt.h"


// ----------------------------------------------------------------------
//   Serial command input
// ----------------------------------------------------------------------

// Character-based code
void loop_btserialcmd(void)
{
  char inchar;
  static bool ignore_at_msg = false;

  while( btSerial.available()>0 ) {
    inchar = btSerial.read();

    if( inchar == -1 ) {
      btLog("btSerial.read() returned zero bytes");
      break;
    }

    // Filter out rogue AT/status messages starting with '+' (e.g., +CONNECTING, +CONNECTED)
    if (inchar == '+') {
      ignore_at_msg = true;
      continue;
    }

    if (ignore_at_msg) {
      if (inchar == '\n' || inchar == '\r') {
        ignore_at_msg = false;
      }
      continue;
    }

    serialcmd(inchar);
  }
}

// Commands
// N kill; f-m power relays 1-8; F-M valve relays 1-8; U-V temp setpoint up/down
// S next next state; Y advance next state; P pause heaters
// A/a heater U/D; B/b speed U/D
void serialcmd(char cmd)
{
  //Serial.print("Entered serialcmd with cmd=");  Serial.println(cmd);

  // Emergency Kill / Stop
  if( cmd == 'N' ) {
    btLog("EMERGENCY STOP (KILL)");
    for( int i=0; i<7; i++ ) {
      setrelay_en(i, ROFF);
      setrelay(i, ROFF);
    }
    pumpsen_reset();
    setpump_perc(RPUMPD, 0);
    setpump_perc(RPUMPR, 0);

    auto_switchstate(STATE_OFF, "Emergency Stop");
    report_rpins();
    report_valve_status();
    report_status();
  }

  // Software reset (restart)
  if( cmd == 'R') {
    //btLog("RESET - called but temporarily disabled");
    ESP.restart();
  }

  // Manual check for OTA updates
  if( cmd == 'o' ) {
    btLog("OTA Check requested via serial command");
    extern void check_for_updates();
    check_for_updates();
  }

  // Force perform OTA update
  if( cmd == 'O' ) {
    if( auto_state != STATE_OFF ) {
      btLog("OTA Update rejected: system is active (must be in STATE_OFF to flash)");
      mqtt_log("OTA Update rejected: Switch to STATE_OFF before updating.");
    } else {
      btLog("OTA Update requested via serial command");
      extern bool ota_pending;
      ota_pending = true;
    }
  }


  // Change main auto mode
  if( cmd == 'a' ) {
    auto_double = !auto_double;
    btLog("Switching main mode auto_double=" + String(auto_double));
    rpinsen_reset();
    pumpsen_reset();
    auto_switchstate(STATE_OFF);
  }

  // Toggle disable heaters
  if( cmd == 'H' ) {
    htrs_forcedisable = !htrs_forcedisable;
    btLog(htrs_forcedisable ? "HEATERS DISABLED" : "HEATERS ACTIVE");
    mqtt_log(htrs_forcedisable ? "HEATERS DISABLED" : "HEATERS ACTIVE");
    report_state();
  }

  // Relays (manual)
  if ( cmd >= 'f' && cmd <= 'l' ) {
    int rno = int(cmd) - int('f');  //Serial.println(rno);
    setrelay_en(rno, !getrelay_en(rno));
  }

  // Toggle Motorised Ball Valve (Pin 5)
  if ( cmd == 'v' || cmd == 'V' ) {
    bool current_state = getrelay(RPBALLVALVE);
    bool next_state = (current_state == ROFF) ? RON : ROFF;
    setrelay_en(RPBALLVALVE, next_state);
    setrelay(RPBALLVALVE, next_state);
    btLog("Toggle: Ball Valve " + String(next_state == RON ? "CLOSED" : "OPEN"));
    report_valve_status();
    report_rpins();
  }

  // Speed control enable pumps
  if ( cmd == 'm' || cmd == 'n') {
    if( cmd=='m' ) {
      setpump_en(RPUMPR, !getpump_en(RPUMPR));
    } else {
      setpump_en(RPUMPD, !getpump_en(RPUMPD));
    }
  }

  // Speed control set speed
  int setperc;
  if ( cmd == 'B' || cmd == 'b') {
    if( cmd=='B') {
      btLog("Calling setpump_perc(RPUMPR, " + String(sc_setperc[RPUMPR] + 5) + ")");
      setpump_perc(RPUMPR, sc_setperc[RPUMPR] + 5);
    } else {
      btLog("Calling setpump_perc(RPUMPR, " + String(sc_setperc[RPUMPR] - 5) + ")");
      setpump_perc(RPUMPR, sc_setperc[RPUMPR] - 5);
    }
  }
  if ( cmd == 'C' || cmd == 'c') {
    if( cmd=='C') {
      btLog("Calling setpump_perc(RPUMPD, " + String(sc_setperc[RPUMPD] + 5) + ")");
      setpump_perc(RPUMPD, sc_setperc[RPUMPD] + 5);
    } else {
      btLog("Calling setpump_perc(RPUMPD, " + String(sc_setperc[RPUMPD] - 5) + ")");
      setpump_perc(RPUMPD, sc_setperc[RPUMPD] - 5);
    }

    // In WASH_HEATER_CTRL, update scavenge_pwm_trim so manual pump speed nudges shift the seeking baseline
    if (auto_state == STATE_WASH && auto_substate == WASH_HEATER_CTRL) {
      float nudge = (cmd == 'C') ? +5.0f : -5.0f;
      scavenge_pwm_trim = constrain(scavenge_pwm_trim - (1.13f * nudge), -30.0f, 30.0f);
      wash_locked_flow = constrain(getlpmFrompwm(sc_setperc[RPUMPD], modeld), 3.0f, 8.5f);
      btLog("WASH_HEATER_CTRL: Manual tune updated delivery to " + String((int)sc_setperc[RPUMPD]) + 
            "% (" + String(wash_locked_flow, 2) + " LPM, trim=" + String(scavenge_pwm_trim, 1) + "%)");
    }
  }

  // Advance next state specifier
  if ( cmd == 'S' ) {
    switch ( auto_nextstate ) {
      case STATE_NONE:  auto_nextstate = STATE_OFF;  break;
      case STATE_OFF:  auto_nextstate = STATE_FILL;  break;
      case STATE_FILL:  auto_nextstate = STATE_WARM;  break;
      case STATE_WARM:  auto_nextstate = STATE_WASH;  break;
      case STATE_WASH:  auto_nextstate = STATE_RINSE;  break;
      case STATE_RINSE: auto_nextstate = STATE_PAUSE;  break;
      case STATE_PAUSE: auto_nextstate = STATE_SHUT;  break;
      case STATE_SHUT:  auto_nextstate = STATE_CALIBP;  break;
      case STATE_CALIBP:  auto_nextstate = STATE_CALIBT;  break;
      case STATE_CALIBT:  auto_nextstate = STATE_CALIBF;  break;
      case STATE_CALIBF:  auto_nextstate = STATE_CALIBDUMP; break;
      case STATE_CALIBDUMP:  auto_nextstate = STATE_OFF;  break;
      case STATE_SETUP1: auto_nextstate = STATE_WARM1; break;
      case STATE_WARM1:  auto_nextstate = STATE_WASH1; break;
      case STATE_WASH1:  auto_nextstate = STATE_PAUSE; break;
    }
    Serial.println("Incrementing auto_nextstate to " + String(auto_statestrs[auto_nextstate]));
    report_state();
  }

  // Temperature setpoint
  if( cmd=='u' || cmd=='U' ) {
    if( cmd=='u' ) temp_setpoint -= 0.5;
    else temp_setpoint += 0.5;
    if( temp_setpoint>60.0 ) temp_setpoint = 40.0;
    save_temp_setpoint();
  }

  // Main 4kW SSR heater duty cycle nudge
  if ( cmd == 'D' || cmd == 'd' ) {
    if ( cmd == 'D' ) {
      ssr_main_duty += 0.05f;
    } else {
      ssr_main_duty -= 0.05f;
    }
    if ( ssr_main_duty > 1.0f ) ssr_main_duty = 1.0f;
    if ( ssr_main_duty < 0.0f ) ssr_main_duty = 0.0f;
    btLog("Main SSR duty: " + String((int)(ssr_main_duty * 100.0f + 0.5f)) + "% (" + String(4.0f * ssr_main_duty, 1) + " kW)");
    report_tsvals();
  }

  // Enter next state
  if ( cmd == 'Y') {
    btLog("Advancing to state " + String(auto_statestrs[auto_nextstate]));
    auto_switchstate(auto_nextstate);  //auto_state = auto_nextstate;
  }

  report_status();
}


// ----------------------------------------------------------------------
//   GUI reporting
// ----------------------------------------------------------------------

// j alive light; i power relay; I valve relay; q flow sense; Q level sense; L log window
// w restarts; M temp graphs; N flow graphs
// t temp setpoint; S beep; n next state; s current state and substate

// Flashing light to indicate bluetooth connection
unsigned long connind_lastupdate = 0;
unsigned long connind_period = 750;
int connind_state = 0;
void report_connblink()
{
  String rcmd = "*jR0G0B0*";
  String gcmd = "*jR255G255B0*";

  if( millis()-connind_lastupdate>=connind_period ) {
    connind_lastupdate = millis();
    connind_state = !connind_state;
    if( connind_state ) btSerial.println(rcmd);
    else btSerial.println(gcmd);
  }
}

void btLog(String mess)
{
  static String lastmess;
  if( mess==lastmess ) return;

  Serial.println("btLog: " + mess);
  btSerial.println("*L" + mess + "\n*");
  lastmess = mess;
}

// Report relay pin outputs
unsigned long rpins_lastreport = 0;
unsigned long rpins_period = 2000;
void report_rpins()
{
  String mstr;

  mstr = "*i";
  for( int i=0; i<8; i++ ) {
    if( getrelay_en(i)==ROFF ) mstr += "0";
    else mstr += "1";
  }
  for( int i=0; i<2; i++ ) {
    if( getpump_en(i)==ROFF ) mstr += "0";
    else mstr += "1";
  }
  mstr += "*";
  btSerial.println(mstr);  //Serial.println(mstr);

  mstr = "*k";
  for( int i=0; i<8; i++ ) {
    if( getrelay(i)==ROFF ) mstr += "0";
    else mstr += "1";
  }
  for( int i=0; i<2; i++ ) {
    if( getpump_en(i)==ROFF ) mstr += "0";
    else mstr += "1";
  }
  mstr += "*";
  btSerial.println(mstr);  //Serial.println(mstr);
  
  rpins_lastreport = millis();
}

// Report ball valve status (v) - ON/Green when CLOSED, OFF/Black when OPEN
unsigned long valve_lastreport = 0;
unsigned long valve_period = 1000;
void report_valve_status(void)
{
  if( getrelay(RPBALLVALVE) == RON ) {
    btSerial.println("*vR0G255B0*");
    btSerial.println("*v1*");
  } else {
    btSerial.println("*vR0G0B0*");
    btSerial.println("*v0*");
  }
  valve_lastreport = millis();
}


// Report temperature & heater status
unsigned long tsvals_lastreport = 0;
unsigned long tsvals_period = 1000;
unsigned long tsready_lastbeep = 0;
unsigned long tsready_beepperiod = 10000;
void report_tsvals()
{
  float main_kw = (getrelay(RPHEATER) == RON) ? (4.0f * constrain(ssr_main_duty, 0.0f, 1.0f)) : 0.0f;
  float aux_kw = (getrelay(RPHEATERA) == RON) ? 2.0f : 0.0f;
  float total_kw = main_kw + aux_kw;
  float bte_htr_level = 40.0f + (total_kw / 6.0f) * 20.0f; // Scale 0..6 kW to 40..60°C for BTE single-axis graph
  int main_duty_pct = (int)(ssr_main_duty * 100.0f + 0.5f);

  String mstr = "*M";
  mstr += String(temp, 1) + "," + String(bte_htr_level, 1) + "," + String(total_kw, 2) + "," + String(main_duty_pct) + "*";
  btSerial.println(mstr);

  mstr = "*W" + String(main_duty_pct) + "*";
  btSerial.println(mstr);

  mstr = "*t";
  mstr += String(temp_setpoint) + "*";
  btSerial.println(mstr);

  // Broadcast ambient temperatures (*aT<amb_water>,<amb_air>*)
  mstr = "*aT" + String(ambient_water_cold, 1) + "," + String(ambient_air_idle, 1) + "*";
  btSerial.println(mstr);

  tsvals_lastreport = millis();
}

// Report analog flow sensor values
unsigned long fsvals_lastreport = 0;
unsigned long fsvals_period = 1000;
void report_fsvals()
{
  String mstr = "*N";
  mstr += String(flow_lpm0, 2) + "," + String(flow_lpm1, 2) + "," + String(flow_lpm1_est, 2);
  mstr += "*";
  btSerial.println(mstr);  //Serial.println(mstr);

  // mstr = "*q";
  // if( flow_lasts0 == 0 ) mstr += 0;
  // else mstr += 1;
  // if( flow_lasts1 == 0 ) mstr += 0;
  // else mstr += 1;
  // mstr += "*";
  // btSerial.println(mstr);  //Serial.println(mstr);

  fsvals_lastreport = millis();
}


// Report levels
unsigned long lsvals_lastreport = 0;
unsigned long lsvals_period = 1500;
void report_lsvals(void)
{
  String mstr = "*Q";

  // Mechanical float switches (Low float: water safe, High float: tank full)
  // Bit 0: '1' = Water present (safe), '0' = Dry (tank_empty)
  // Bit 1: '1' = Full / Overflow,     '0' = Normal level
  mstr += tank_empty ? "0" : "1";
  mstr += tank_full ? "1" : "0";

  mstr += "*";
  btSerial.println(mstr);  //Serial.println(mstr);

  // Percent full tank (estimated from flow)
  mstr = "*X";
  float level_hestp = level_hest/level_htank*100.0;
  mstr += String(level_hestp,0);
  mstr += "*";
  btSerial.println(mstr);  //Serial.println(mstr);

  // Percentage full tank (from ranging level sensor)
  mstr = "*Y";
  float level_hrp = (level_htank - (rlevdsens/10))/level_htank*100;
  mstr += String(level_hrp,0);
  mstr += "*";
  btSerial.println(mstr);  //Serial.println(mstr);

  lsvals_lastreport = millis();
}


// Report pressure
unsigned long psval_lastreport = 0;
unsigned long psval_period = 1000;
void report_psvals(void)
{
  String mstr = "*P";
  mstr += String(psens0,1);
  mstr += "*";
  btSerial.println(mstr);  //Serial.println(mstr);

  psval_lastreport = millis();
}


// Report speed control
unsigned long scval_lastreport = 0;
unsigned long scval_period = 1000;
void report_scvals(void)
{
  String mstr = "*f";
  if( sc_setperc[RPUMPR]>99 ) mstr += "99";
  else mstr += String(sc_setperc[RPUMPR],0);
  mstr += "*";
  btSerial.println(mstr);  //Serial.println(mstr);

  mstr = "*F";
  if( sc_setperc[RPUMPD]>99 ) mstr += "99";
  else mstr += String(sc_setperc[RPUMPD],0);
  mstr += "*";
  btSerial.println(mstr);  //Serial.println(mstr);

  scval_lastreport = millis();
}


// Report OTA version
// extern String ota_version;
unsigned long otaversion_lastreport = 0;
unsigned long otaversion_period = 1000;
void report_otaversion(void)
{
  extern bool ota_update_available;

  // Z contains version, and appends a star '*' if a newer update is available
  String mstr = "*Z";
  mstr += String(OTA_VERSION);
  if (ota_update_available) {
    mstr += "*";
  }
  mstr += "*";
  btSerial.println(mstr);

  otaversion_lastreport = millis();
}


// Report state
unsigned long state_lastreport = 0;
unsigned long state_period = 1500;
void report_state(void)
{
  String mstr;

  mstr = "*AR0G0B0*";
  if( auto_double ) mstr = "*AR255G255B255*";
  btSerial.println(mstr);

  mstr = "*HR255G0B0*";
  if( htrs_forcedisable || !htrs_enable ) mstr = "*HR0G0B0*";
  btSerial.println(mstr);

  if( auto_state==STATE_NONE ) mstr = "*sNONE*";
  else {
    const char *auto_substatestr = auto_substatestrs[auto_substate];
    mstr = "*s" + String(auto_statestrs[auto_state]) + ": " + auto_substatestr + "*";
  }
  btSerial.println(mstr);
    
  mstr = "*n" + String(auto_statestrs[auto_nextstate]) + "*";
  btSerial.println(mstr);

  //String mstr = "*a";
  //for( int i=0; i<4; i++ ) {
  //  if( digitalRead(LSPINS[i]) ) mstr += "1";
  //  else mstr += "0";
  //}
  //mstr += "*";
  //btSerial.println(mstr);  //Serial.println(mstr0);

  state_lastreport = millis();
}


void report_network_status(void)
{
  // WiFi Status (y)
  String wifi_led = "*yR255G0B0*"; // Red by default (disconnected)
#if ENABLE_WIFI
  if (WiFi.status() == WL_CONNECTED) {
    long rssi = WiFi.RSSI();
    if (rssi >= -65) {
      wifi_led = "*yR0G255B0*"; // Green (Good signal)
    } else {
      wifi_led = "*yR255G165B0*"; // Orange/Yellow (Okay/Weak signal)
    }
    static unsigned long last_ip_report = 0;
    if (millis() - last_ip_report >= 3000) {
      last_ip_report = millis();
      btSerial.println("*I" + WiFi.localIP().toString() + "*");
      btSerial.println("*r" + String(rssi) + "*");
    }
  }
#endif
  btSerial.println(wifi_led);

  // MQTT Status (x)
  String mqtt_led = "*xR255G0B0*"; // Red by default (disconnected)
#if ENABLE_MQTT
  #if ENABLE_WIFI
  if (WiFi.status() == WL_CONNECTED) {
  #endif
    if (client.connected()) {
      mqtt_led = "*xR0G255B0*"; // Green (Connected)
    } else {
      mqtt_led = "*xR255G165B0*"; // Orange/Yellow (Connecting/connecting issue)
    }
  #if ENABLE_WIFI
  }
  #endif
#endif
  btSerial.println(mqtt_led);

  // Wired Serial log data (every 15 seconds, only if there is a connection problem)
  static unsigned long last_serial_net_log = 0;
  if (millis() - last_serial_net_log >= 15000) {
    last_serial_net_log = millis();
    bool wifi_ok = false;
#if ENABLE_WIFI
    wifi_ok = (WiFi.status() == WL_CONNECTED);
#else
    wifi_ok = true; 
#endif

    bool mqtt_ok = false;
#if ENABLE_MQTT
    mqtt_ok = client.connected();
#else
    mqtt_ok = true; 
#endif

    if (!wifi_ok || !mqtt_ok) {
      String wifi_status_str = "DISCONNECTED";
#if ENABLE_WIFI
      if (WiFi.status() == WL_CONNECTED) {
        wifi_status_str = "CONNECTED (RSSI: " + String(WiFi.RSSI()) + " dBm)";
      } else if (WiFi.status() == WL_IDLE_STATUS || WiFi.status() == WL_SCAN_COMPLETED) {
        wifi_status_str = "SCANNING/CONNECTING";
      }
#else
      wifi_status_str = "DISABLED";
#endif

      String mqtt_status_str = "DISCONNECTED";
#if ENABLE_MQTT
      if (client.connected()) {
        mqtt_status_str = "CONNECTED";
      } else {
        mqtt_status_str = "DISCONNECTED (State: " + String(client.state()) + ")";
      }
#else
      mqtt_status_str = "DISABLED";
#endif

      Serial.printf("Net Diagnostics Alert: WiFi = %s | MQTT = %s | State = %s\n", 
                    wifi_status_str.c_str(), 
                    mqtt_status_str.c_str(), 
                    auto_statestrs[auto_state]);
    }
  }
}


// Report all
void report_status(void)
{
  if( millis()-otaversion_lastreport>=otaversion_period ) report_otaversion();
  if( millis()-rpins_lastreport>=rpins_period ) report_rpins();
  if( millis()-valve_lastreport>=valve_period ) report_valve_status();
  if( millis()-tsvals_lastreport>=tsvals_period ) report_tsvals();
  if( millis()-fsvals_lastreport>=fsvals_period ) report_fsvals();
  if( millis()-lsvals_lastreport>=lsvals_period ) report_lsvals();
  if( millis()-psval_lastreport>=psval_period ) report_psvals();
  if( millis()-scval_lastreport>=scval_period ) report_scvals();
  if( millis()-state_lastreport>=state_period ) report_state();
  report_network_status();
}
