nicollsf/monsoon/(commit log)

2026-03-22 Initial commit of Monsoon project files
    [NTC_10K_1P_lut.csv, Untitled.dxf, heater_safety.fzz, monsoon_esp.fzz, monsoon_mega.fzz, monsoon_mega2.fzz, monsoon_mega3.fzz, scavenge_level.fzz]
2026-04-08 Temperature control and footswitch
2026-07-12 Refactor: Implement safe recovery pump and inlet control via vetoes
2026-08-31 Implement manual OTA control, split version/update telemetry, non-blocking queue logging, 9LPM WASH speed limit, PAUSE state heater safety control, and a refined Python background datalogger client
    [monsoon_esp32devkit.fzz]
2026-09-06 Migrate OTA server, MQTT broker, and web GUI to new Raspberry Pi at 10.0.0.9, auto-control ball valve on FILL and SHUT, and expand web GUI manual overrides
    [auto.cpp, deploy_ota.py, gui.cpp, monsoon_logger.py, mqtt.h, ota.h, sensors.cpp, system.cpp]
2026-09-12 Enhance flow control, ball valve lifecycle, datalogging, and safety vetoes
    - Limit delivery flow during FILL (40% in FILL_PREPARE, 8.0 LPM in FILL_OVERFILL_PUMP)
    - Maintain recovery flow at +1.0 LPM above delivery in autoscavenge
    - Add 8s soft-start (<= 4.0 LPM) and continuous dynamic mass-balance flow guard in WASH
    - Cap PID speed control limits between 3.0 and 8.0 LPM
    - Implement 5-minute delayed reopening for motorized ball valve on entering STATE_OFF
    - Add 3000ms debounce confirmation for level sensor before re-arming physical heaters
    - Add over-temperature safety cutout when flow is clamped during TCSPEED
    - Expand telemetry tokens and datalogger fields (relay intent/actual bits, level s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
2026-09-13 Implement temperature median filtering, WASH_SOFTSTART substate, closed-loop scavenge tracking, and staged thermal control (v1.0.47)
    - Add 9-sample ADC median filter and 5-point rolling window median in sensors.cpp to eliminate temperature spikes
    - Fix 1Hz temperature measurement cadence in loop_tempsens1
    - Introduce explicit WASH_SOFTSTART substate in auto.cpp with rate-limited ramp (+0.5 LPM/s) and sensor-driven exit criteria
    - Implement closed-loop PI recovery flow control in loop_autoscavengecontrol tracking flow_lpm0 + 1.0 LPM with anti-windup clamping
    - Add 4-stage heater power ladder (6kW / 4kW / 2kW / 0kW) in control.cpp for filter-restricted thermal management
    - Bump OTA_VERSION to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
    [auto.cpp, auto.h, control.cpp, control.h, ota.h, sensors.cpp]
2026-09-13 Implement STATE_CALIBF multi-point flow balance calibration (v1.0.50)
2026-09-13 Fix motorized ball valve 5-minute delayed reopening on STATE_OFF (v1.0.51)
    [auto.cpp, ota.h, system.cpp, system.h]
2026-09-13 Implement switch-to-switch volumetric relative flow calibration (v1.0.52)
2026-09-13 Fix pump power relay gating and port opening for CALIBF (v1.0.53)
    [calib.cpp, control.cpp, ota.h]
2026-09-13 Restore calibration routines and deploy v1.0.55
2026-09-13 Implement 5-point piecewise linear recovery flow calibration table in NVRAM (v1.0.56)
2026-09-13 Add unrecorded warmup/de-aeration cycle to CALIBF before 5-point calibration (v1.0.57)
2026-09-13 Enable 3-trace flow telemetry (Delivery, Raw Recovery, Estimated Recovery) in firmware and telemetry (v1.0.58)
2026-09-13 Fix OTA MQTT callback flooding and ensure automatic reboot on update (v1.0.59)
    [ota.cpp, ota.h]
2026-09-13 Update web GUI monsoon.html with 3-trace flow chart and raw/est telemetry cards
2026-09-13 Implement two-stage WARM architecture with WARM_RAMP and WARM_HOLD staged thermal soak (v1.0.60)
2026-09-13 Add OTA safety guard, track current state in GUI, and update AGENTS.md for WARM pipeline
2026-09-14 Implement dynamic scavenge delta ramping (+1.2 LPM/min) in calibrated delivery units and fix datalogger level mapping
    [auto.cpp, control.cpp, monsoon_logger.py]
2026-09-15 Standardize scavenge control in true delivery flow units with immediate delta snap on tank_full
2026-09-16 Add 95% PWM 6th point to CALIBF routine, bump v1.0.68
2026-09-17 Scavenge & Hydraulic Protection fixes: instant integral reset on tank_full, mass-balance anti-windup, and gate hydraulic clamp on PWM1 >= 80% (v1.0.69)
    [auto.cpp, control.cpp, ota.h]
2026-09-17 Set recovery pump to full speed (100% PWM) during FILL_PREPARE, bump v1.0.70
2026-09-17 Add Flow1_Rec_Est (calibrated recovery flow) column to CSV datalogger
2026-09-18 Fix flow calibration monotonicity and robust slope extrapolation, bump v1.0.71
    [ota.h, sensors.cpp]
2026-09-18 Add 4th flow trace for target recovery and 25s tank_full stabilization latch (v1.0.72)
2026-09-18 Allow manual C/c delivery pump adjustments during WARM and implement direct CALIBF PWM feedforward (v1.0.73)
2026-09-20 Add dedicated manual pump speed tuning, master heaters switch, and float switch indicators to monsoon.html
2026-09-20 Remove single/two pump mode toggle from monsoon.html
2026-09-21 Fix hydraulic delivery flow capping and staged heater fallback using calibrated recovery flow
    [control.cpp]
2026-09-22 Fix Emergency Stop to preserve 5-minute ball valve delay (v1.0.79)
    [gui.cpp, ota.h]
2026-09-22 Implement power-recovery ball valve holding on boot (v1.0.80)
2026-09-23 Add Schmitt trigger hysteresis to hydraulic clamp and heater down-staging (v1.0.81)
2026-09-24 Fix delivery hydraulic clamp oscillation and improve heater staging stability (v1.0.82)
    [control.cpp, ota.h]
2026-09-27 Simplify TCSPEED control: shed Aux heater on recovery PWM saturation and keep pure PID delivery (v1.0.83)
2026-09-28 Tune TCSPEED PID (Kp=1.0, Ki=0.004, Kd=0.8) for smooth, natural thermal deceleration (v1.0.84)
2026-10-05 Add GPIO 33 slow-PWM SSR control for Aux heater (v1.0.85)
2026-10-06 Implement Aux SSR Power Supervisor with slow timebase and deadband (v1.0.87)
2026-10-06 Deploy v1.0.88: Aux SSR Duty UI & Dual-Trace Power Graph
2026-10-07 Deploy v1.0.90: Fix PAUSE heater enable bug, smooth PID & pump slew rate, add thermal model
    [auto.cpp, control.cpp, ota.h]
2026-10-07 Deploy v1.0.91: Clean up level telemetry *Q to 2-digit mechanical float switches
2026-10-09 Ensure both heaters ON and Aux SSR reset to 100% on entering WARM and WASH (v1.0.92)
    [auto.cpp, ota.h]
2026-10-11 Switch SSR temperature control to 4kW Main heater, update GUI, telemetry, and docs (v1.0.93)
2026-10-11 Increase heater shed rate by ~3x in kW and tighten supervisor cadence to 10s (v1.0.94)
2026-10-11 Tune power supervisor shedding rate by ~2x for balanced thermal-hydraulic response (v1.0.96)
2026-10-11 Rate limit recovery pump (+6% PWM/s) and increase Monsoon flow creep to +140W/15s (v1.0.99)
2026-10-13 Add flow feedforward assistance, power floor, and calibrated thermal model (v1.0.102)
2026-10-14 Fix flow stoppage in CALIBT step test by preserving delivery pump and relay across substates (v1.0.105)
2026-10-15 Persist calibrated thermal model profile 'shower with roof on and through main shower head' (v1.0.107)
2026-10-15 Overlay fitted FOPDT model curve (R^2=0.995) onto calibration plot
2026-10-15 Implement classical PI heater supervisor and pure PID delivery flow control (v1.0.108)
2026-10-15 Add derivative phase-lead damping to recovery power supervisor (v1.0.109)
2026-10-15 Store calibration run and thermal comparison for stall roof OFF (2026-10-15)
2026-10-15 Fix XML entity encoding in calibration SVG plots
2026-10-16 Expand delivery flow limit to 6.5 LPM and raise initial power to 5.2 kW (v1.0.110)
2026-10-17 Implement two-regime WASH architecture (FLOW_CTRL and HEATER_CTRL) (v1.0.111)
2026-10-17 Lower WASH transition threshold to 75% recovery PWM (v1.0.112)
2026-10-19 Require reliably observed recovery >78% and verified heater headroom for WASH transition (v1.0.113)
2026-10-19 Adjust WASH transition steady-state heater headroom threshold to 5.5 kW (v1.0.114)
2026-10-19 Damp TCSPEED with 2.5s sample time, damped gains, and 0.12 LPM/s rate limiter (v1.0.116)
2026-10-20 Support delivery PWM nudging in WASH_HEATER_CTRL, 30s thermal fallback to WASH_FLOW_CTRL, and tighten scavenge trim (v1.0.117)
2026-10-20 Implement direct float-centric PWM scavenge balancing, deprecate get_recovery_pwm_from_flow (v1.0.118)
2026-10-20 Remove redundant EMA filter and slew limiter from recovery pump (v1.0.119)
2026-10-20 Remove deprecated temp_pred_45s and flow Rec target traces (v1.0.121)
2026-10-20 Remove -8%/+25% clamps from recovery seeking controller (v1.0.122)
2026-10-20 Add calibrated 1.10x base, symmetric 0.08%/s ramp, and midpoint anti-windup to scavenge controller (v1.0.123)
2026-10-22 v1.0.126: Fix flow slew limiter, re-tune TCSPEED & TCHEATER, cap delivery flow and add anti-starvation trim
2026-10-23 v1.0.127: Lock recovery PWM at 80% in WASH_HEATER_CTRL and switch level control to delivery flow
